Makertech3D/Proforge-3/README.md

# Proforge-3
Repository for documentation and resources related to the Proforge 3 3D Printer.
