Makertech3D/Proforge-3/3D Printed Parts STL's/DSH_Fan Shroud V2.STL

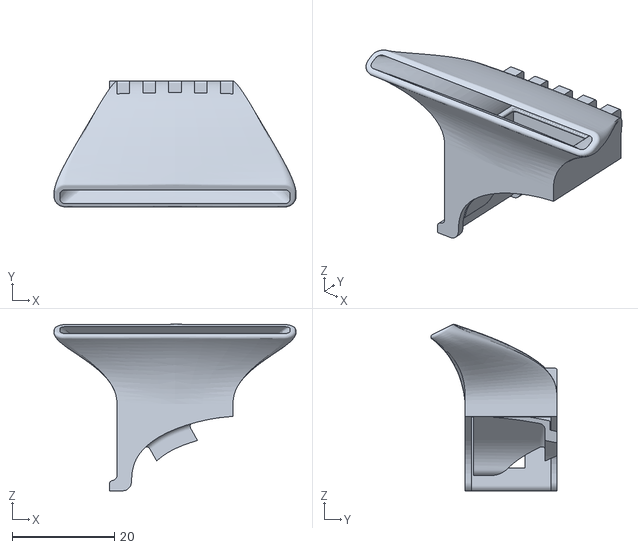
[picture p1: CAD file, 2022-07-18]
3D Printed Parts STL's/DSH_Fan Shroud V2.STL
47.3 x 24.7 x 32.6
