Makertech3D/Proforge-3/Part Drawings/P3_Pi Cam Case.STEP

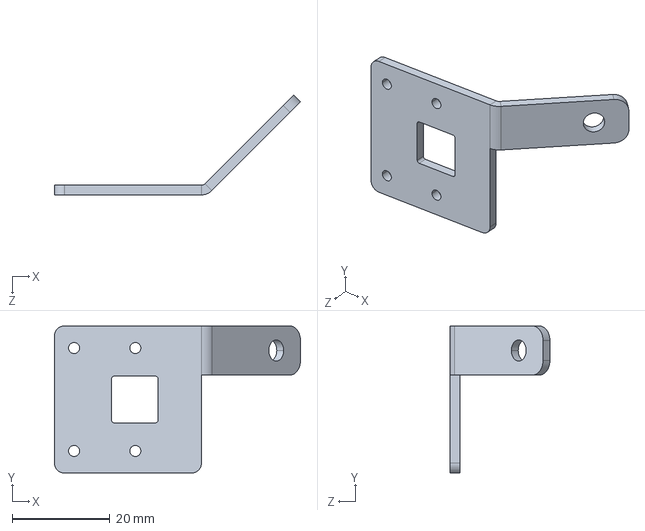
[picture p2: CAD file, 2022-07-18]
Part Drawings/P3_Pi Cam Case.STEP
50.2 x 30.0 x 20.4 mm
