Makertech3D/Proforge-3/3D Printed Parts STL's/DSH_Servo Arm V2.STL

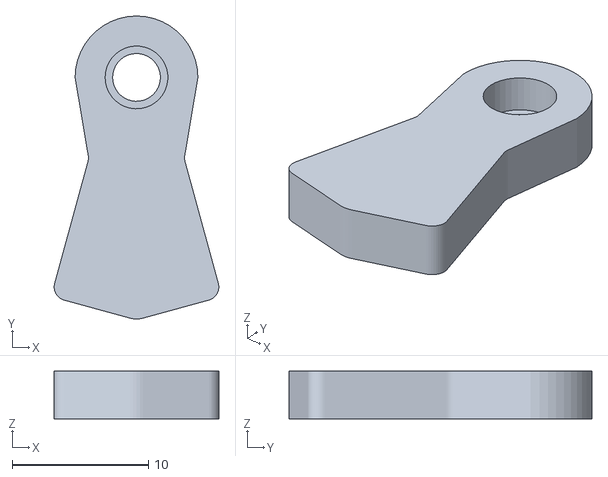
[picture p3: CAD file, 2022-07-18]
3D Printed Parts STL's/DSH_Servo Arm V2.STL
12.1 x 22.2 x 3.50
