Makertech3D/Proforge-3/Part Drawings/P3_MIC-6 Platform.STEP

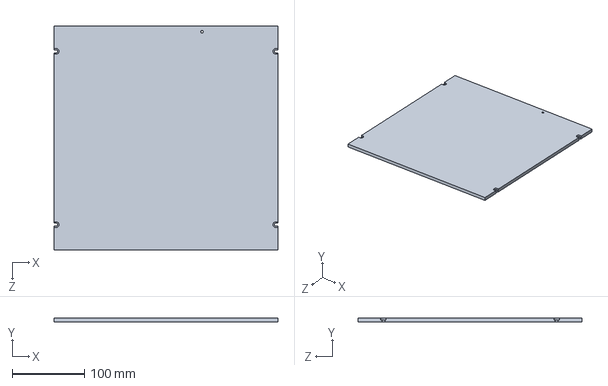
[picture p4: CAD file, 2022-07-18]
Part Drawings/P3_MIC-6 Platform.STEP
310.0 x 6.00 x 310.0 mm
