Makertech3D/Proforge-3/3D Printed Parts STL's/OctoPi_Pi Cam Case.STL

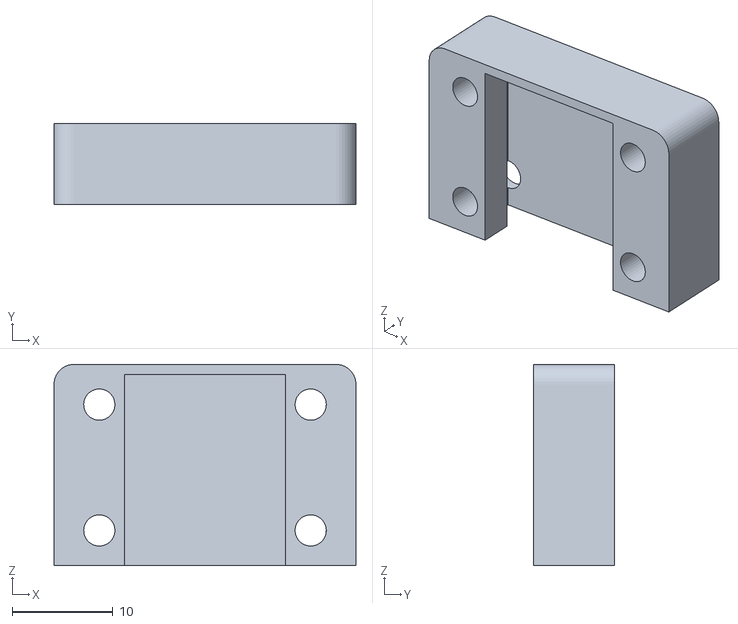
[picture p5: CAD file, 2022-03-18]
3D Printed Parts STL's/OctoPi_Pi Cam Case.STL
30.0 x 8.00 x 20.0
