Makertech3D/Proforge-3/Part Drawings/P3_Top Panel.STEP

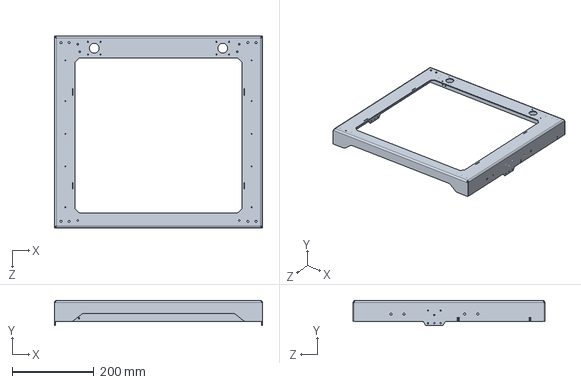
[picture p6: CAD file, 2022-07-18]
Part Drawings/P3_Top Panel.STEP
510.0 x 62.0 x 470.0 mm
