Makertech3D/Proforge-3/3D Printed Parts STL's/Enclosure_Filter Case.STL

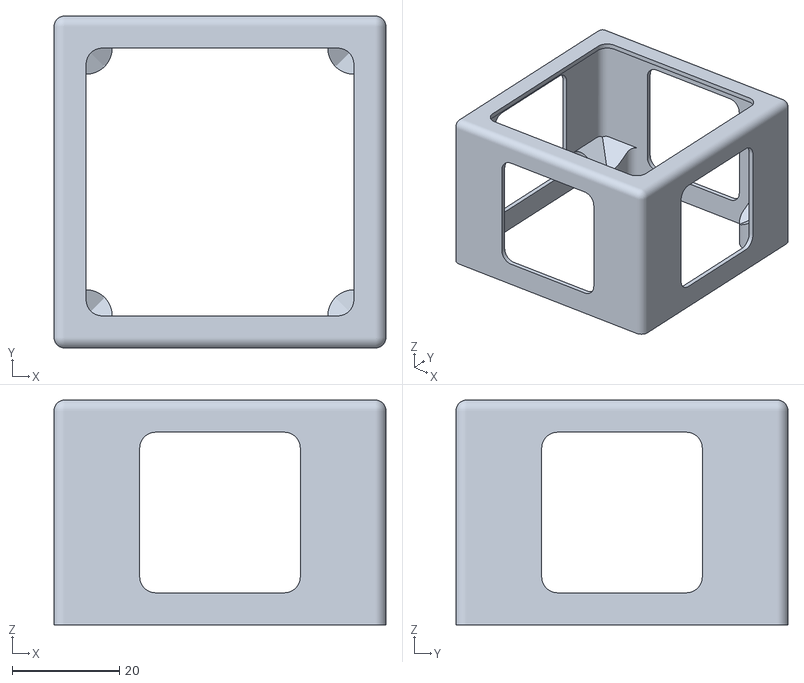
[picture p7: CAD file, 2022-03-18]
3D Printed Parts STL's/Enclosure_Filter Case.STL
62.0 x 62.0 x 42.0
