Makertech3D/Proforge-3/Part Drawings/P3_Filament Sensor Mount.STEP

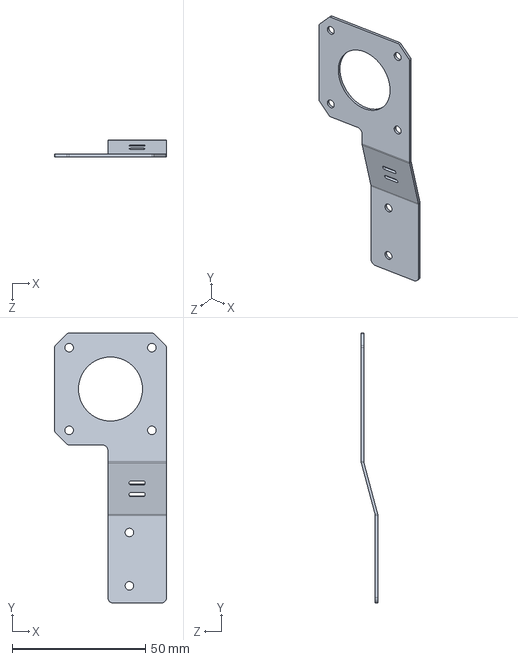
[picture p8: CAD file, 2022-07-18]
Part Drawings/P3_Filament Sensor Mount.STEP
42.0 x 101.2 x 6.30 mm
