Makertech3D/Proforge-3/3D Printed Parts STL's/DD_Fan Case.STL

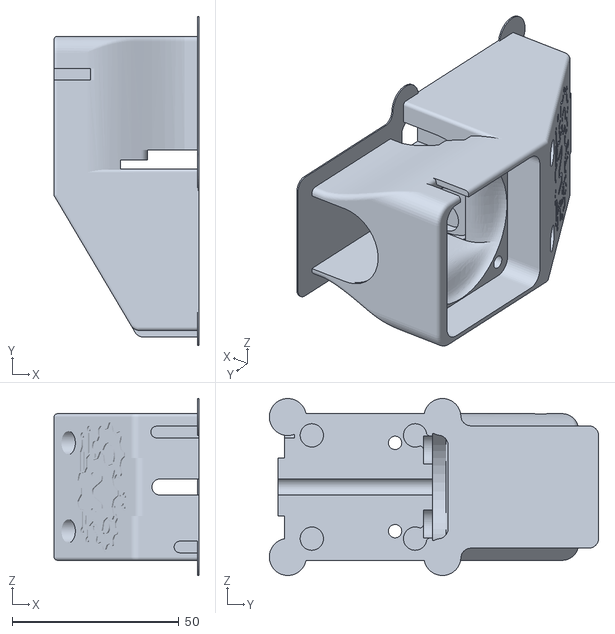
[picture p9: CAD file, 2022-03-18]
3D Printed Parts STL's/DD_Fan Case.STL
43.5 x 98.9 x 53.1
