Makertech3D/Proforge-3/Part Drawings/P3_Belt Clamp.STEP

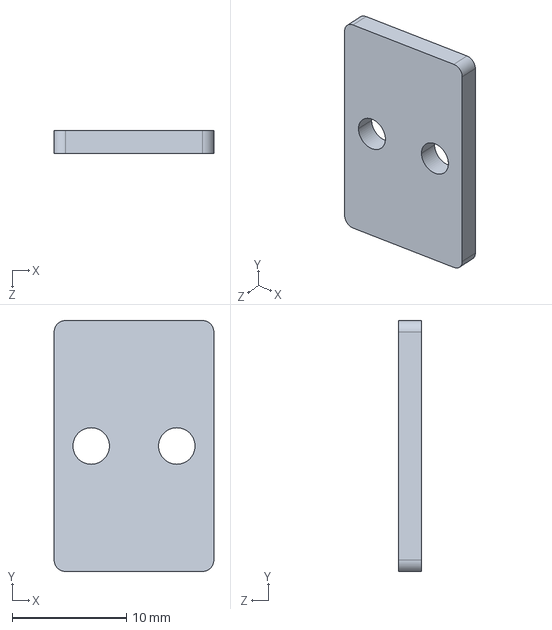
[picture p10: CAD file, 2022-07-18]
Part Drawings/P3_Belt Clamp.STEP
14.0 x 22.0 x 2.00 mm
