Makertech3D/Proforge-3/3D Printed Parts STL's/DSH_Probe Mount.STL

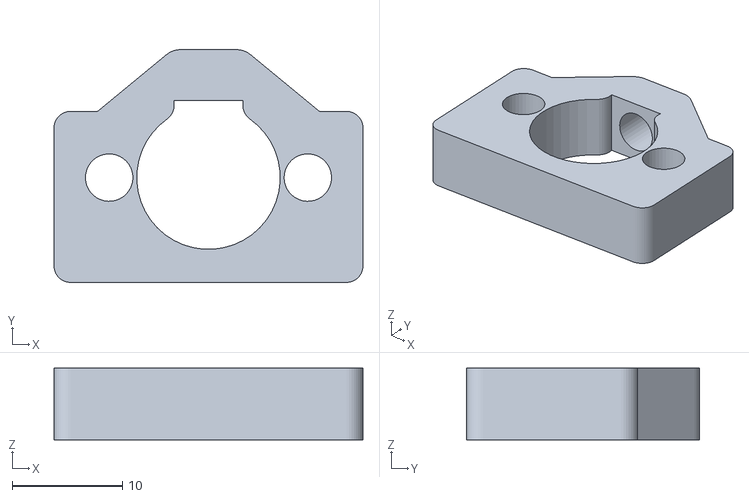
[picture p11: CAD file, 2022-03-18]
3D Printed Parts STL's/DSH_Probe Mount.STL
28.0 x 21.1 x 6.50
