Makertech3D/Proforge-3/Part Drawings/P3_Enclosure Roof.STEP

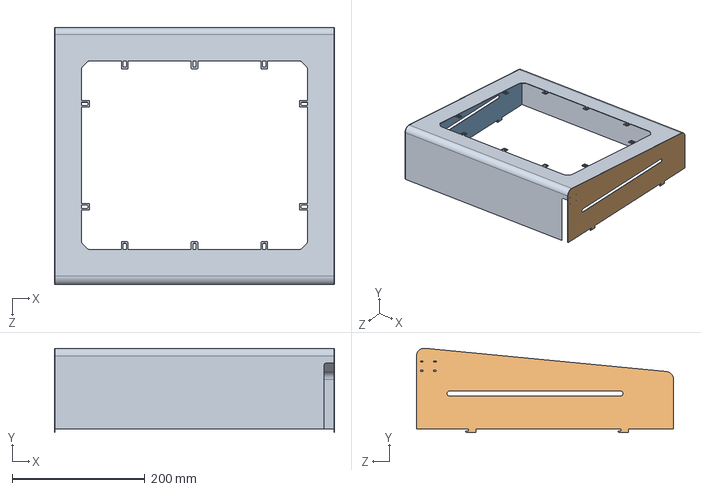
[picture p12: CAD file, 2022-07-18]
Part Drawings/P3_Enclosure Roof.STEP
422.3 x 127.4 x 388.0 mm
