Makertech3D/Proforge-3/3D Printed Parts STL's/DD_Fan Shroud (mirror for other side).STL

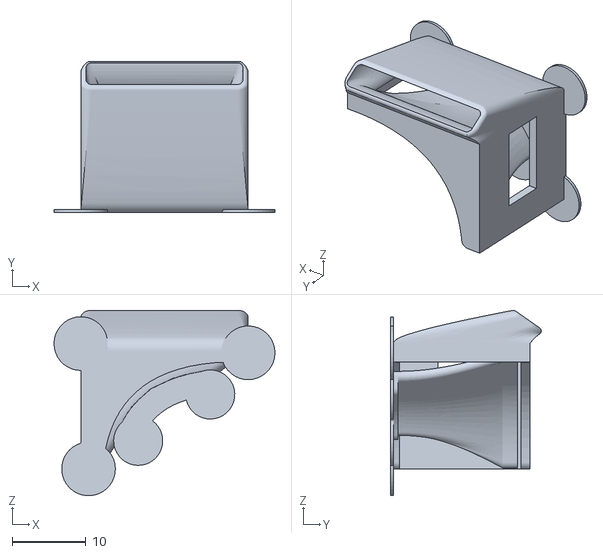
[picture p13: CAD file, 2022-03-18]
3D Printed Parts STL's/DD_Fan Shroud (mirror for other side).STL
30.0 x 20.4 x 25.2
