Makertech3D/Proforge-3/Part Drawings/P3_LCD Case_BTT_v3.STEP

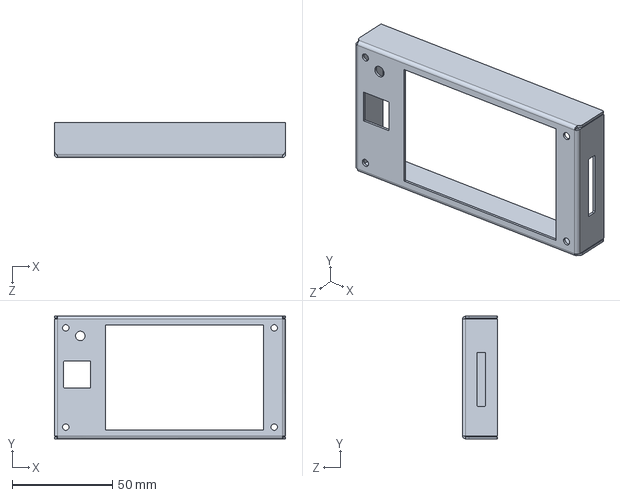
[picture p14: CAD file, 2022-07-18]
Part Drawings/P3_LCD Case_BTT_v3.STEP
115.0 x 61.0 x 17.5 mm
