Makertech3D/Proforge-3/3D Printed Parts STL's/P3_Foot.STL

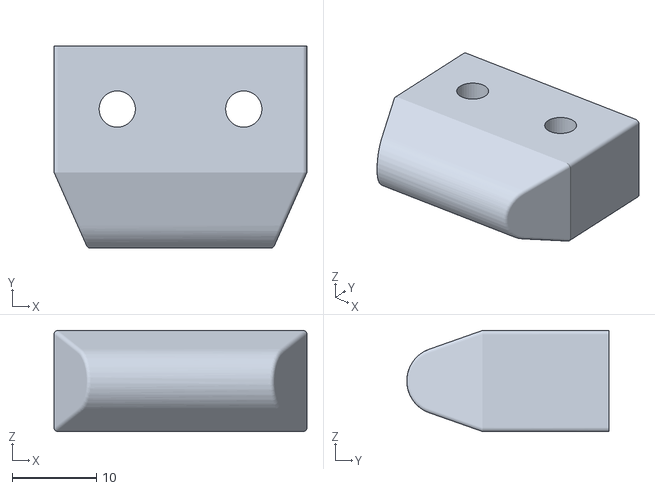
[picture p15: CAD file, 2022-03-18]
3D Printed Parts STL's/P3_Foot.STL
30.0 x 24.0 x 12.0
