Makertech3D/Proforge-3/Part Drawings/DSH2_Backplate.STEP

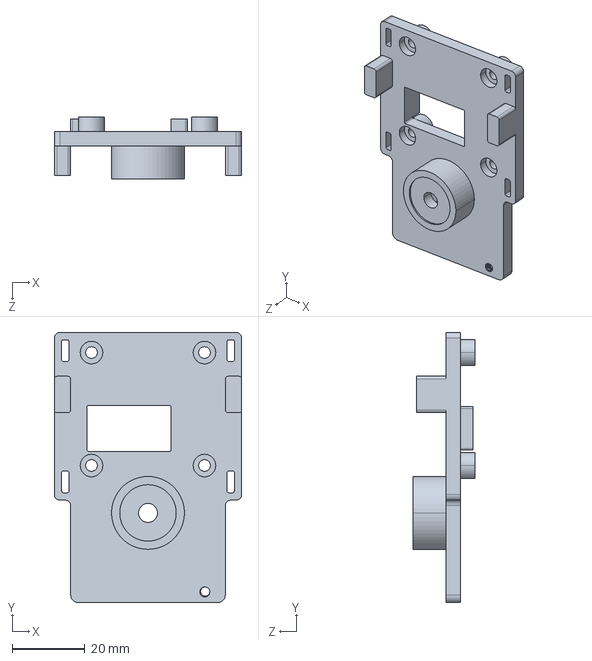
[picture p16: CAD file, 2022-07-18]
Part Drawings/DSH2_Backplate.STEP
51.4 x 74.1 x 17.0 mm
