Makertech3D/Proforge-3/3D Printed Parts STL's/DSH_Fan Mount.STL

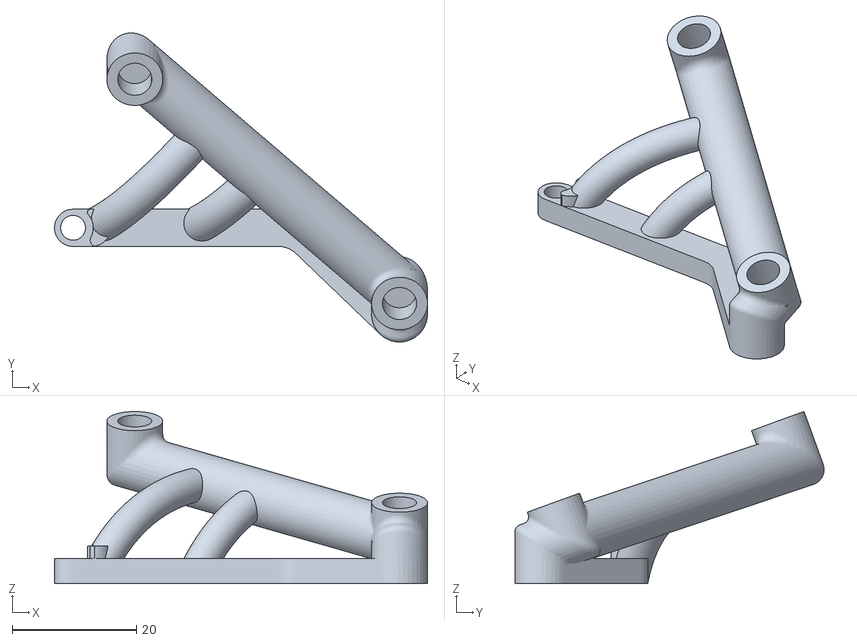
[picture p17: CAD file, 2022-03-18]
3D Printed Parts STL's/DSH_Fan Mount.STL
60.0 x 49.7 x 27.7
