Makertech3D/Proforge-3/Part Drawings/P3_Tool Carriage.STEP

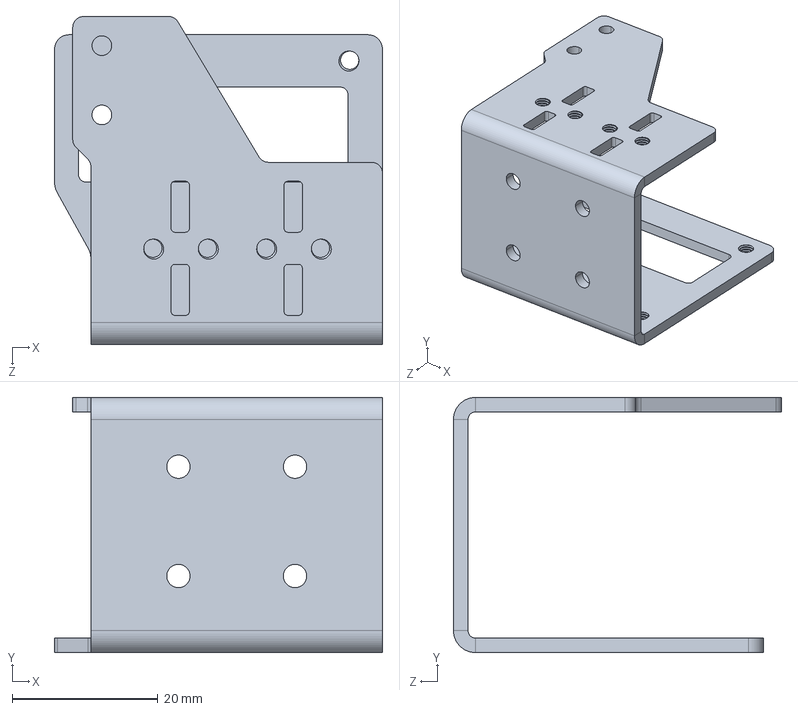
[picture p18: CAD file, 2022-07-18]
Part Drawings/P3_Tool Carriage.STEP
45.0 x 35.0 x 45.0 mm
