Makertech3D/Proforge-3/3D Printed Parts STL's/OctoPi_KIS3R33S Bracket.STL

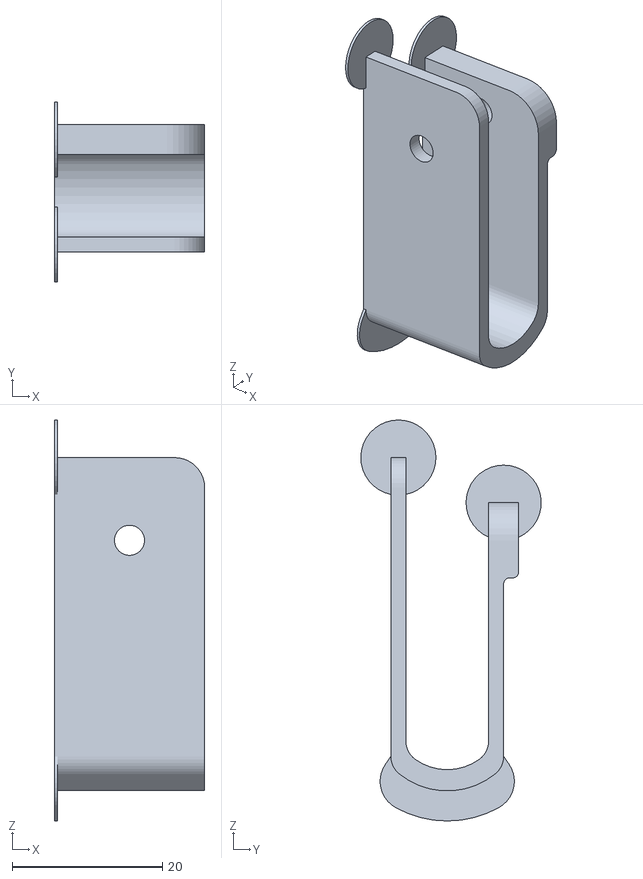
[picture p19: CAD file, 2022-03-18]
3D Printed Parts STL's/OctoPi_KIS3R33S Bracket.STL
20.0 x 24.0 x 53.3
