Makertech3D/Proforge-3/Part Drawings/Tool Carriage.STEP

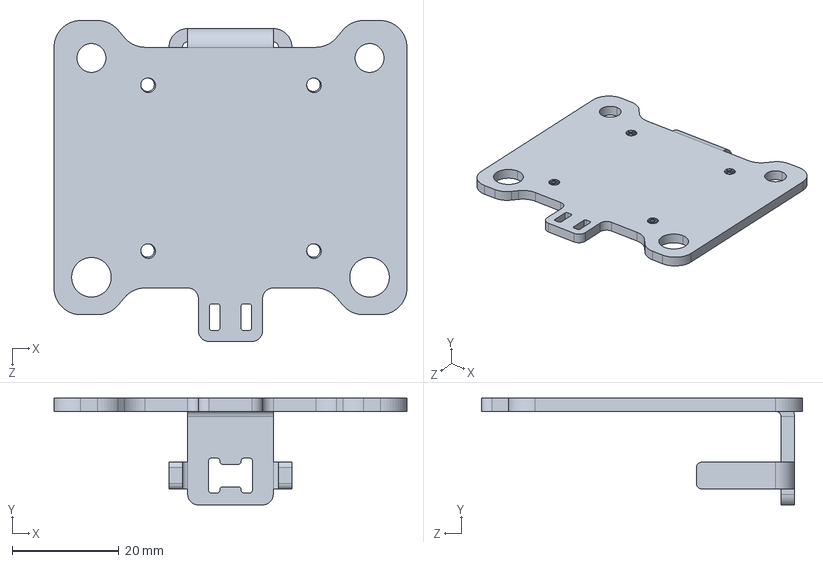
[picture p20: CAD file, 2022-07-18]
Part Drawings/Tool Carriage.STEP
66.0 x 20.0 x 60.0 mm
