Makertech3D/Proforge-3/3D Printed Parts STL's/DD_Filament Sensor Mount.STL

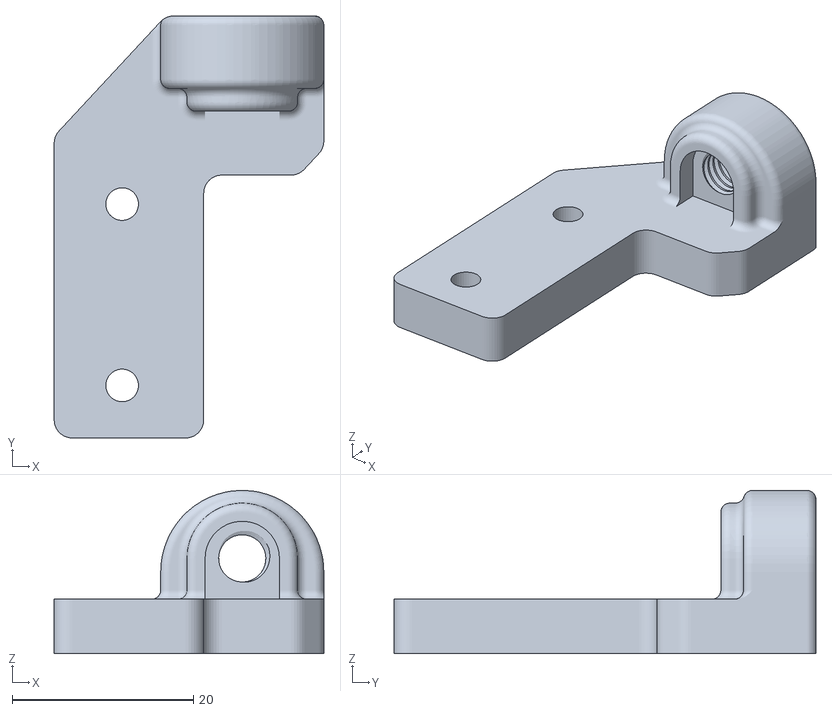
[picture p21: CAD file, 2022-03-18]
3D Printed Parts STL's/DD_Filament Sensor Mount.STL
29.8 x 46.5 x 18.0
