Makertech3D/Proforge-3/Part Drawings/DSH2_Probe and Fan Mount.STEP

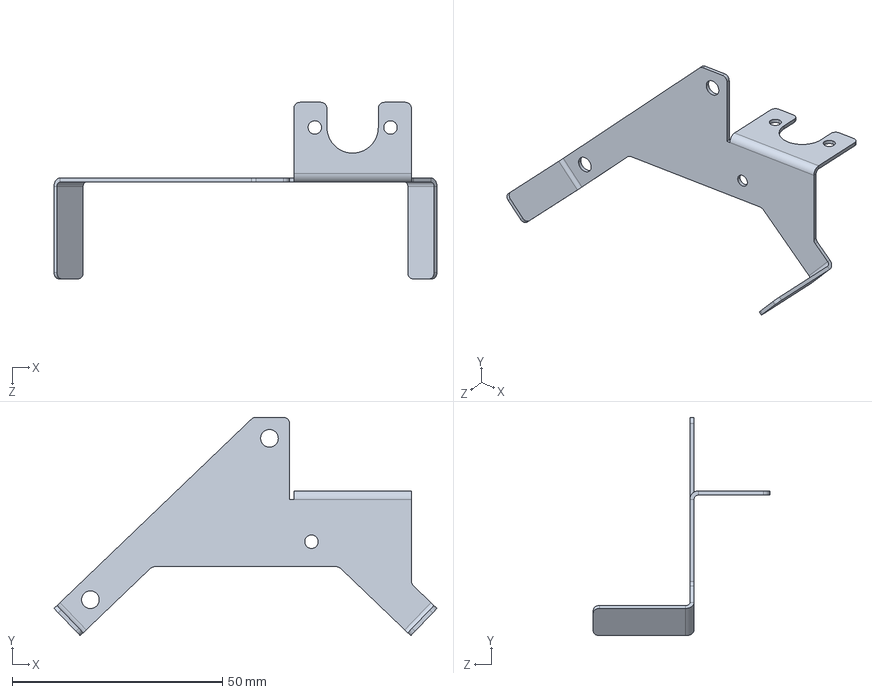
[picture p22: CAD file, 2022-07-18]
Part Drawings/DSH2_Probe and Fan Mount.STEP
91.1 x 52.0 x 42.0 mm
