Makertech3D/Proforge-3/Part Drawings/P3_Base.STEP

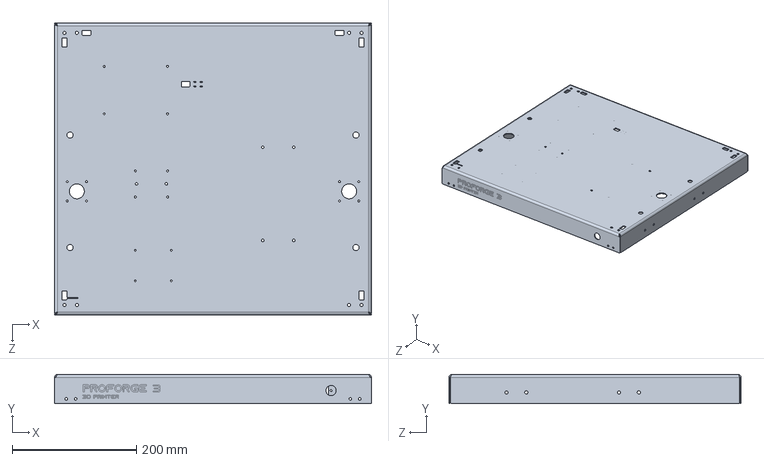
[picture p23: CAD file, 2022-07-18]
Part Drawings/P3_Base.STEP
510.0 x 47.0 x 470.1 mm
