Makertech3D/Proforge-3/Part Drawings/P3_Enclosure Lock.STEP

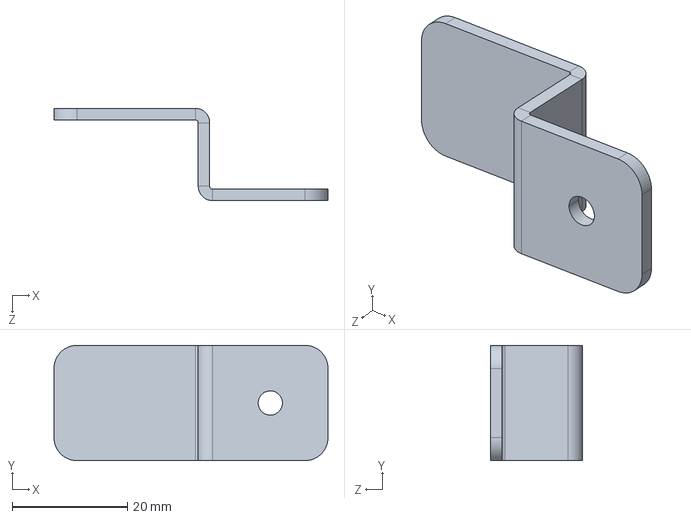
[picture p24: CAD file, 2022-07-18]
Part Drawings/P3_Enclosure Lock.STEP
47.5 x 20.0 x 16.0 mm
