Makertech3D/Proforge-3/Part Drawings/DD Mount.STEP

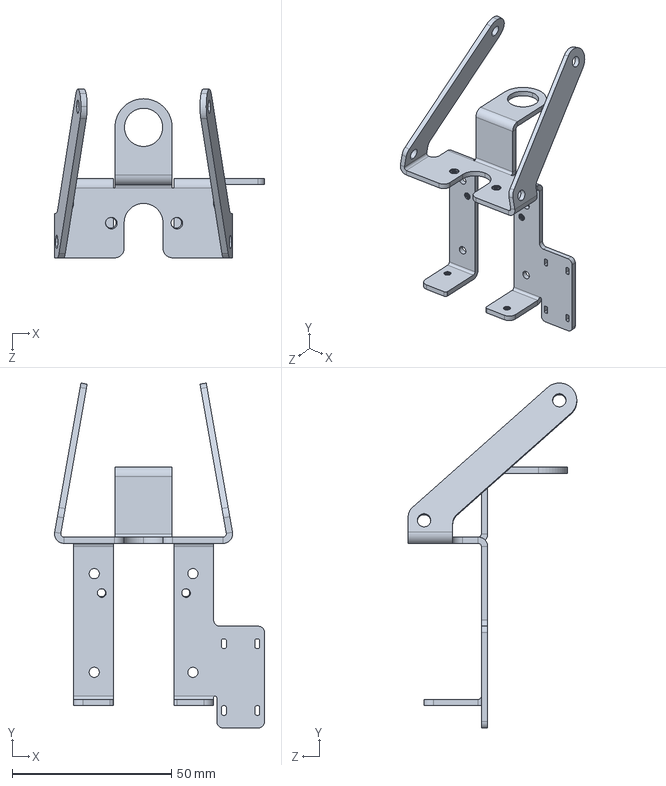
[picture p25: CAD file, 2022-07-18]
Part Drawings/DD Mount.STEP
66.0 x 108.4 x 53.0 mm
