Makertech3D/Proforge-3/Part Drawings/P3_Gantry.STEP

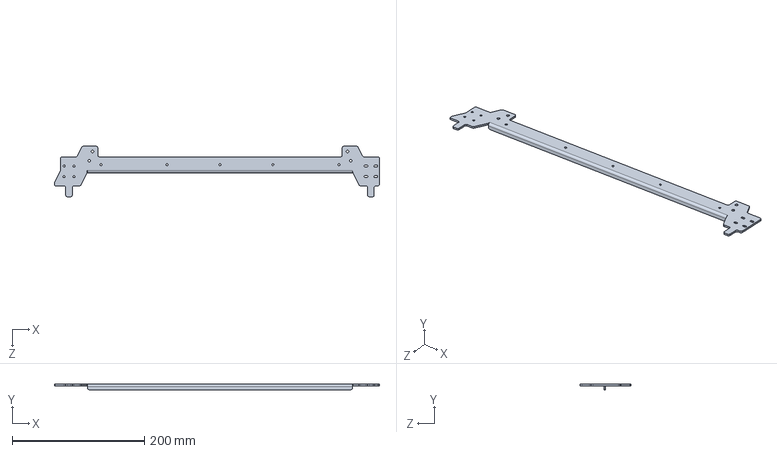
[picture p26: CAD file, 2022-07-18]
Part Drawings/P3_Gantry.STEP
492.0 x 8.50 x 76.5 mm
