Makertech3D/Proforge-3/Part Drawings/P3_LCD Case Back_BTT_v3.STEP

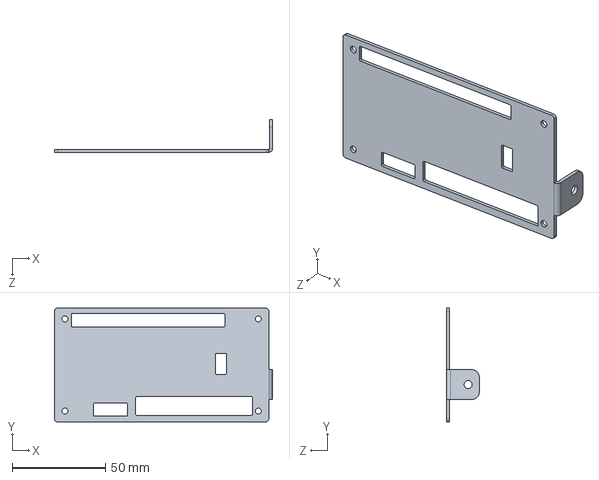
[picture p27: CAD file, 2022-07-18]
Part Drawings/P3_LCD Case Back_BTT_v3.STEP
117.0 x 61.0 x 17.5 mm
