Makertech3D/Proforge-3/Part Drawings/P3_Bed Cable Relief.STEP

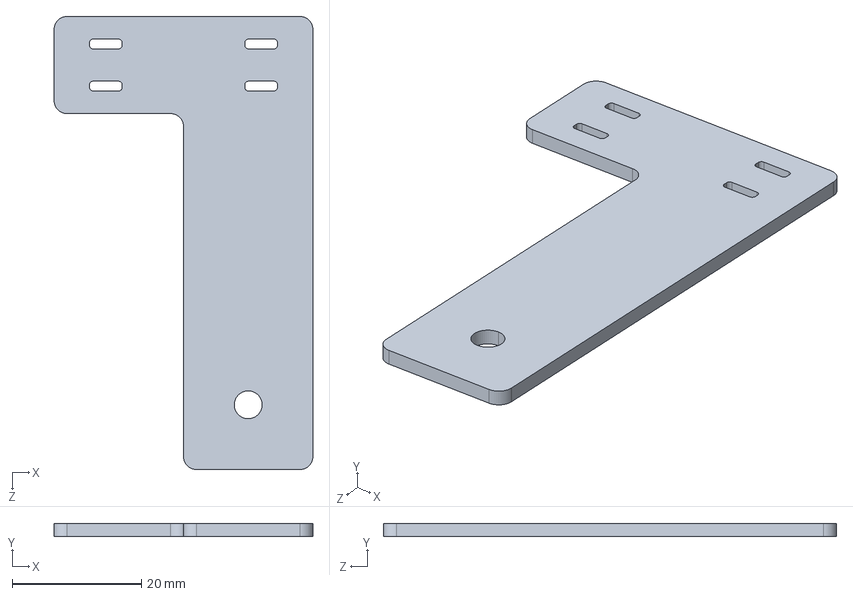
[picture p28: CAD file, 2022-07-18]
Part Drawings/P3_Bed Cable Relief.STEP
40.0 x 2.00 x 70.0 mm
