Makertech3D/Proforge-3/(threads)

Thread 1 (2022-03-02):

Initial bugs after release

freddy2312, 2022-03-02:
These were the following mistakes I found:
- X and Y Axis are inverted
- Temperature is very sure false (180°C smells very burned
- PID is not tuned correct
- when loading and unloading, the Bed goes up like 4cm before the filament comes out!!!
- when started the error „failed to enable Bed Leveling“ pops up on the screen

Makertech3D, 2022-03-06:
Stepper directions have been further investigated. The cables on our set-up were inverted in comparison to the ones in inventory. Firmware has been updated. If issues persist, we recommend either compiling from source and inverting the stepper directions or just post a message here, and we'll upload compiled inverted stepper firmwares.

freddy2312, 2022-03-07:
Thanks for updating and for sharing the source! Do you already know when you will upload the cad files and the 3D print files? Thanks a lot :)

Thread 2 (2022-05-07):

missing name in thermistornames.h

PowerChaos, 2022-05-07:
hi,
this is just a bug report and a quick fix

as i was compiling i keep getting the error that it can not complete the compile
seems that thermistor ID 560 is not defined in Thermistornames.h

after adding it manual to it , then it compiles
This is for the source code

can you update it in the zip file please

`#elif THERMISTOR_ID == 560
   #define THERMISTOR_NAME "Makertech High Temp. Thermistor"
`

Thank you
Greetings from PowerChhaos

Thread 3 (2024-03-11):

Part Drawings enclosure panels

octocom, 2024-03-11:
Hi,

Can you add the enclosure panels part drawings please, seem to be missing.

Best Regards

Luke
