Makertech3D/Proforge-3/Part Drawings/DD Mount.pdf

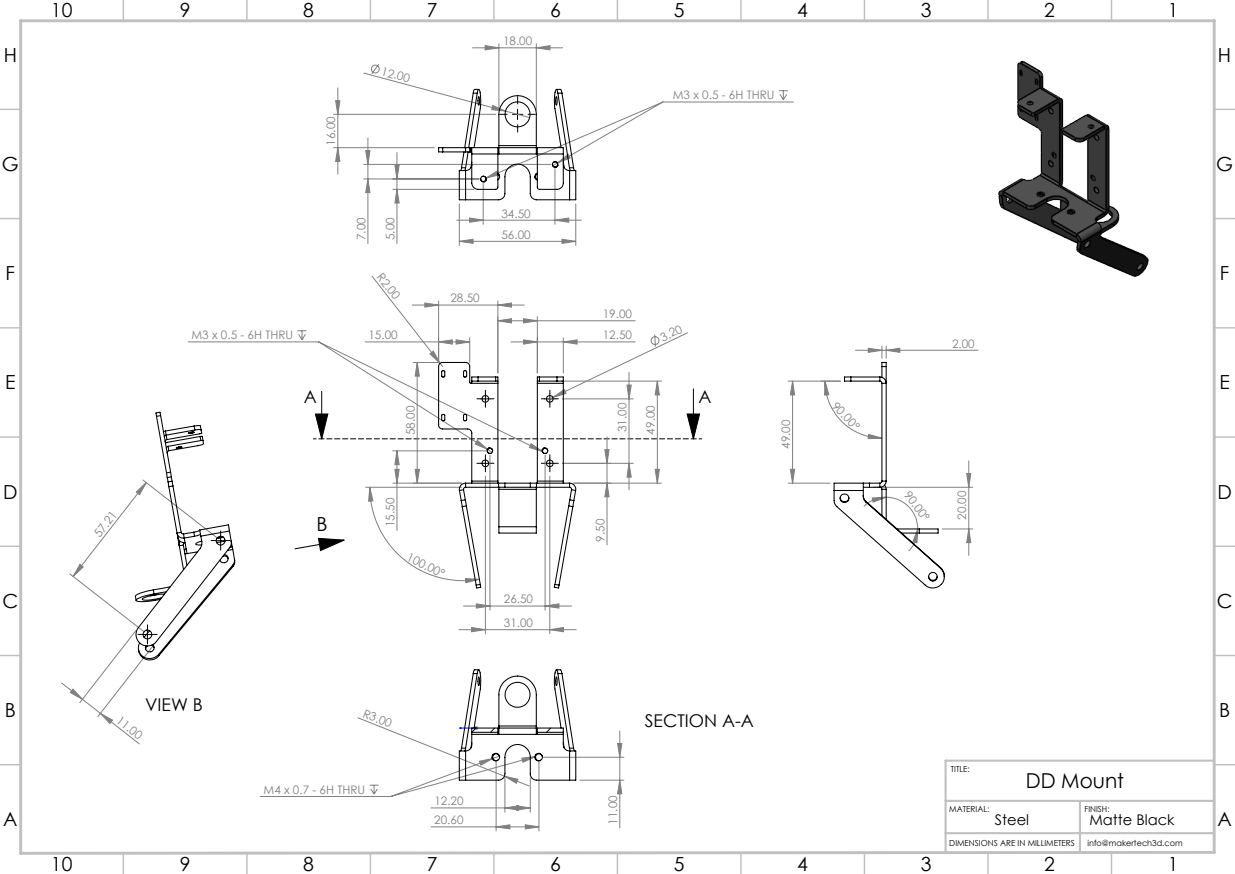
[picture p29: page 1]
M3 x 0.5 - 6H THRU; M4 x 0.7 - 6H THRU; SECTION A-A 11.00; VIEW B; DD Mount

MATERIAL: | FINISH: Matte Black

DIMENSIONS ARE IN MILLIMETERS | info@makertech3d.com
