Makertech3D/Proforge-3/Part Drawings/DSH2_Backplate.pdf

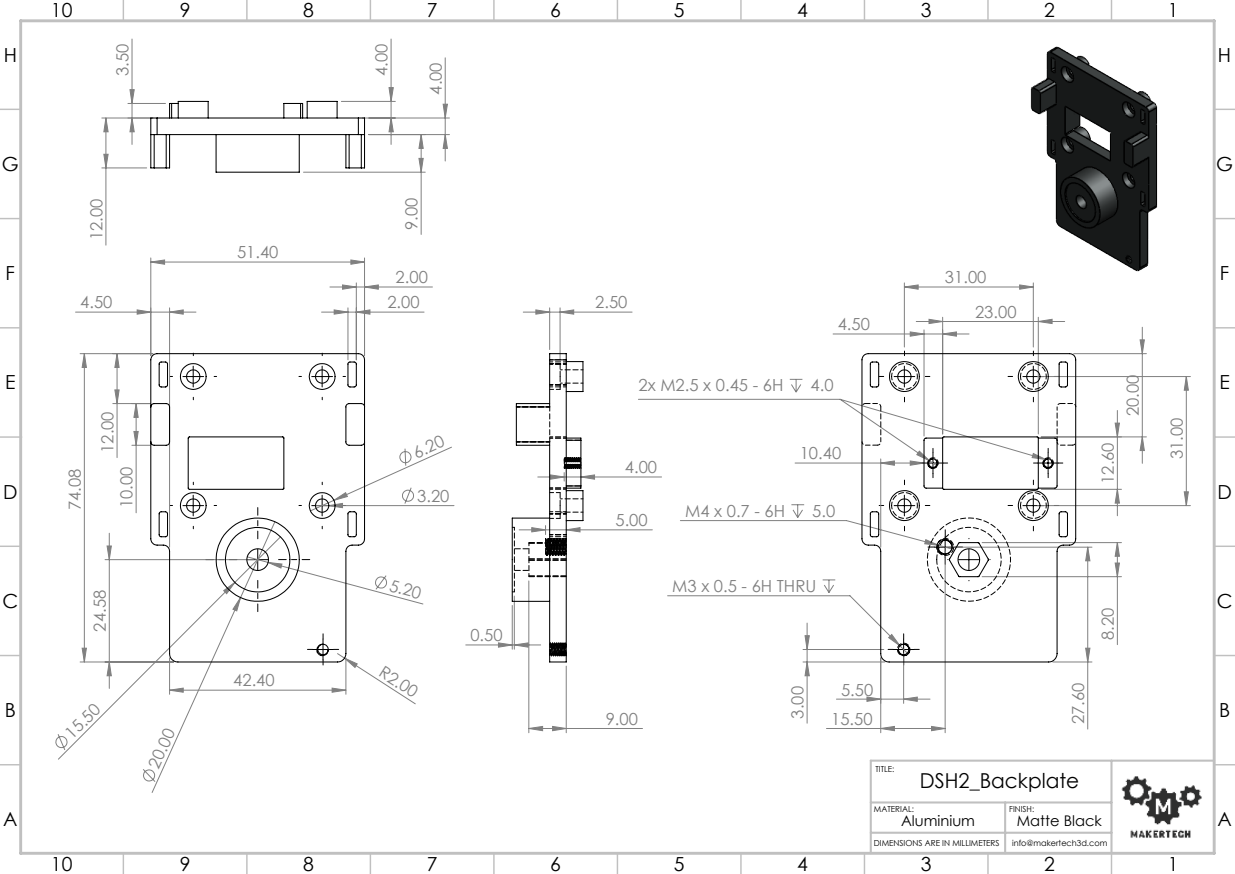
[picture p30: page 1]
M3 x 0.5 - 6H THRU; Matte Black

TITLE: DSH2_Backplate

MATERIAL: Aluminium | FINISH:

DIMENSIONS ARE IN MILLIMETERS | info@makertech3d.com
