Makertech3D/Proforge-3/Part Drawings/DSH2_Heatsink.pdf

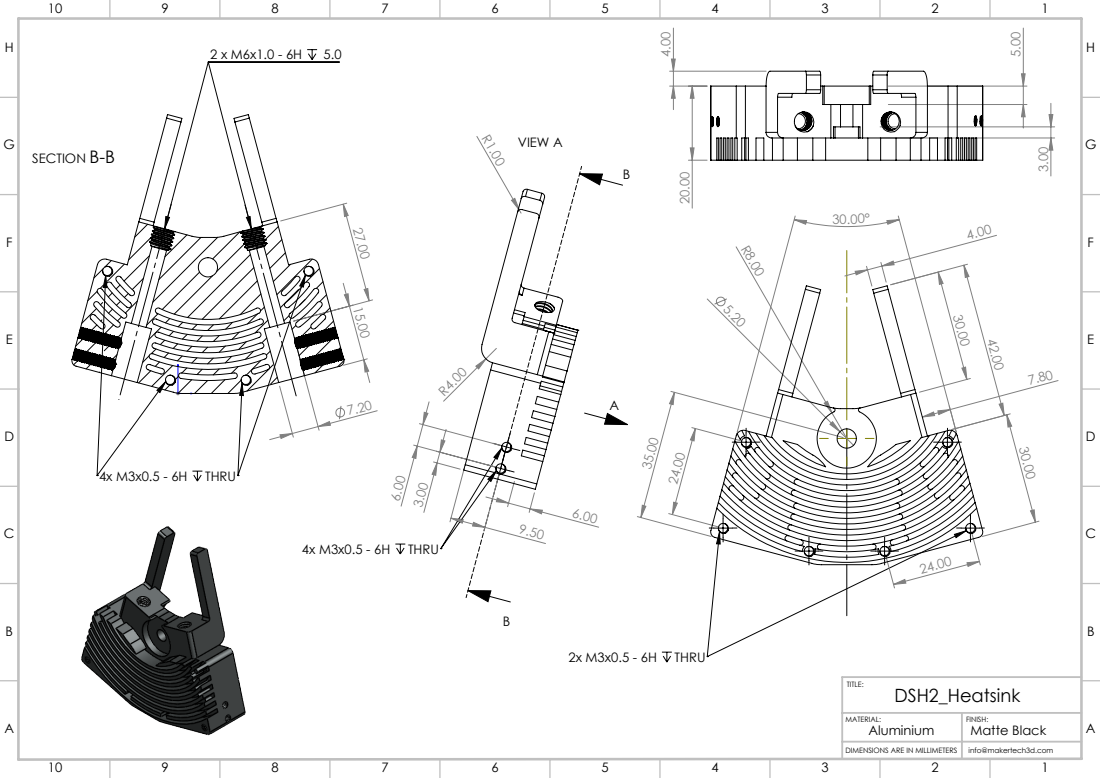
[picture p31: page 1]
2x M3x0.5 - 6H THRU 20.00 4.00; VIEW A; 4x M3x0.5 - 6H THRU; SECTION B-B

MATERIAL: | FINISH: Matte Black

DIMENSIONS ARE IN MILLIMETERS | info@makertech3d.com
