Makertech3D/Proforge-3/Part Drawings/DSH2_Probe and Fan Mount.pdf

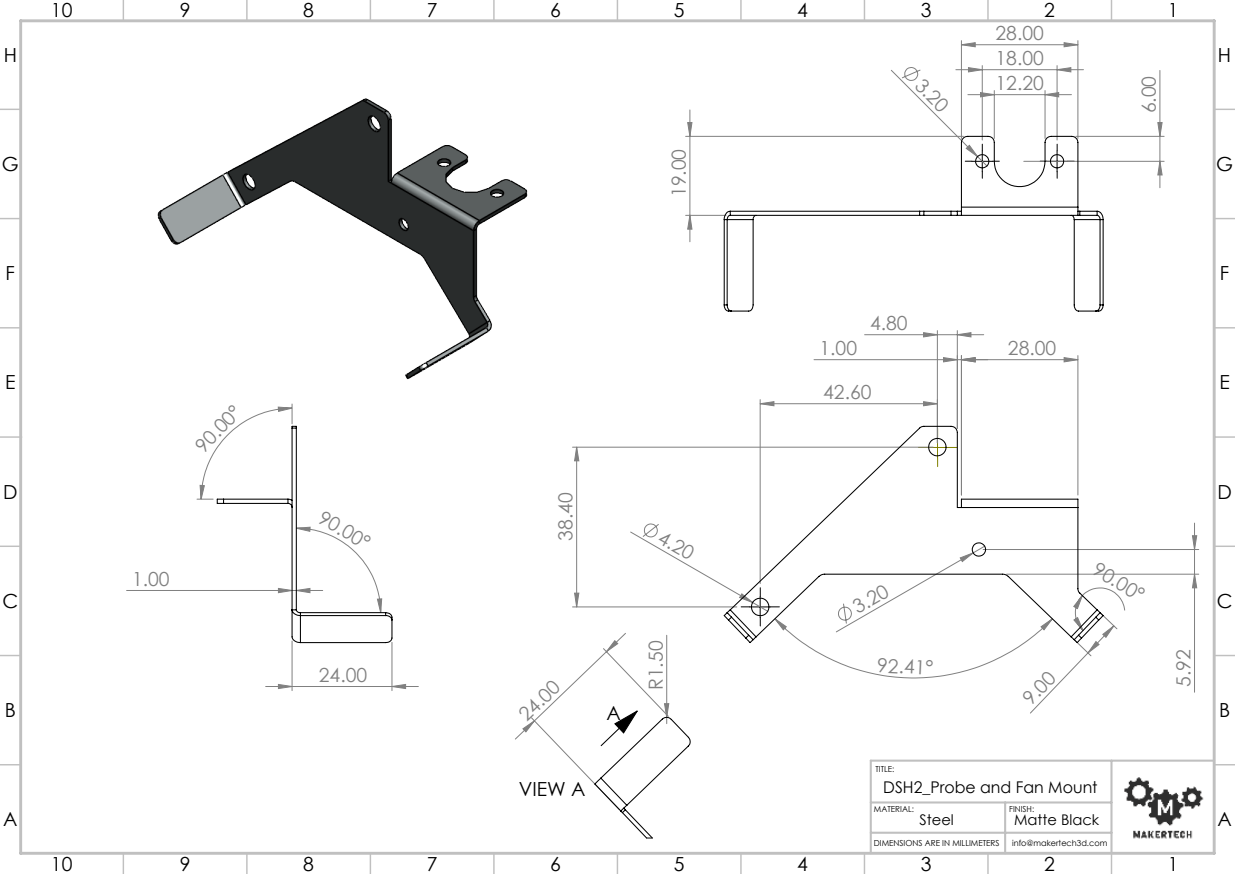
[picture p32: page 1]
VIEW A

TITLE: DSH2_Probe and Fan Mount

MATERIAL: | FINISH: Matte Black

DIMENSIONS ARE IN MILLIMETERS | info@makertech3d.com
