Makertech3D/Proforge-3/Part Drawings/P3_Base.pdf

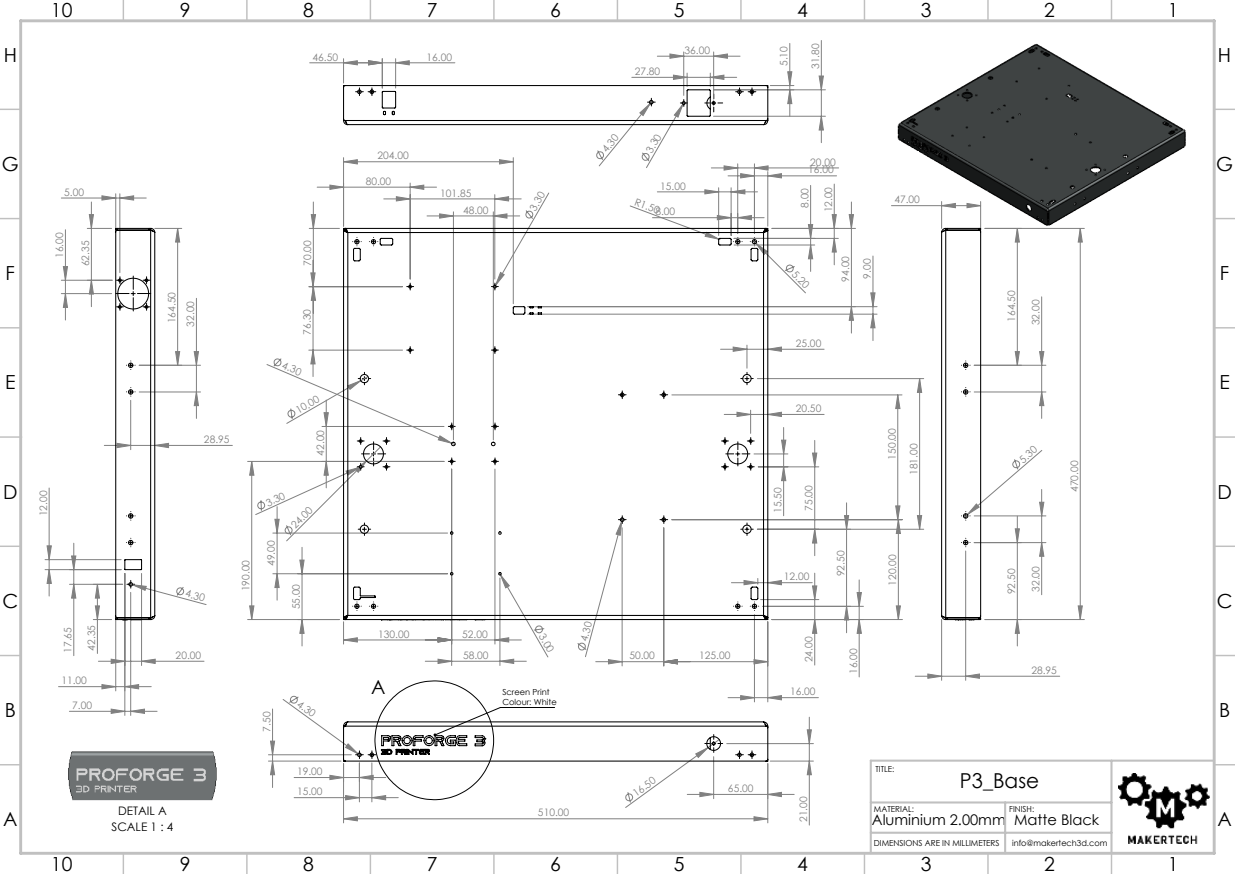
[picture p33: page 1]
Screen Print; Colour: White; DETAIL A SCALE 1 : 4; Aluminium 2.00mm

TITLE: P3_Base

MATERIAL: | FINISH: Matte Black

DIMENSIONS ARE IN MILLIMETERS | info@makertech3d.com

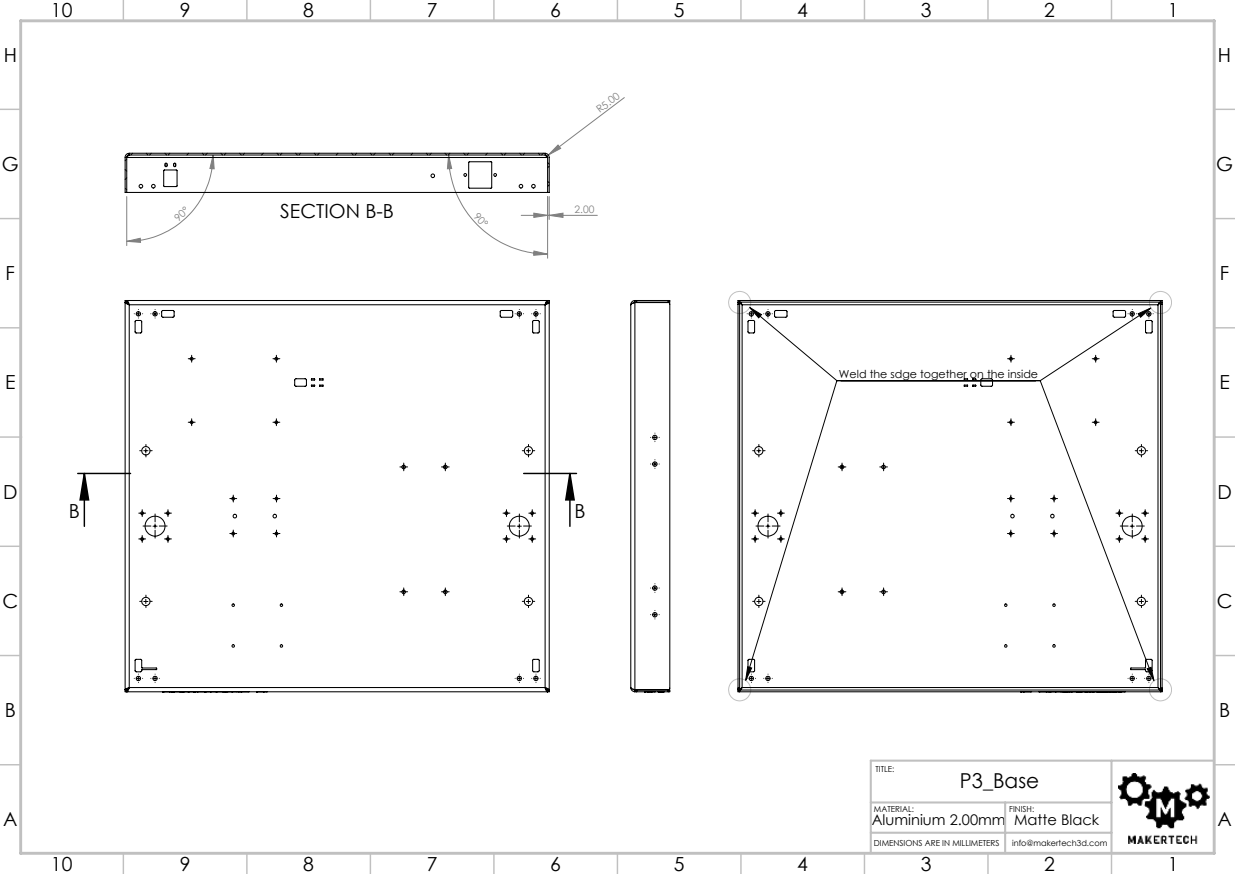
[picture p34: page 2]
SECTION B-B; Aluminium 2.00mm

Weld the sdge together on the inside

TITLE: P3_Base

MATERIAL: | FINISH: Matte Black

DIMENSIONS ARE IN MILLIMETERS | info@makertech3d.com
