Makertech3D/Proforge-3/Part Drawings/P3_Bed Cable Relief.pdf

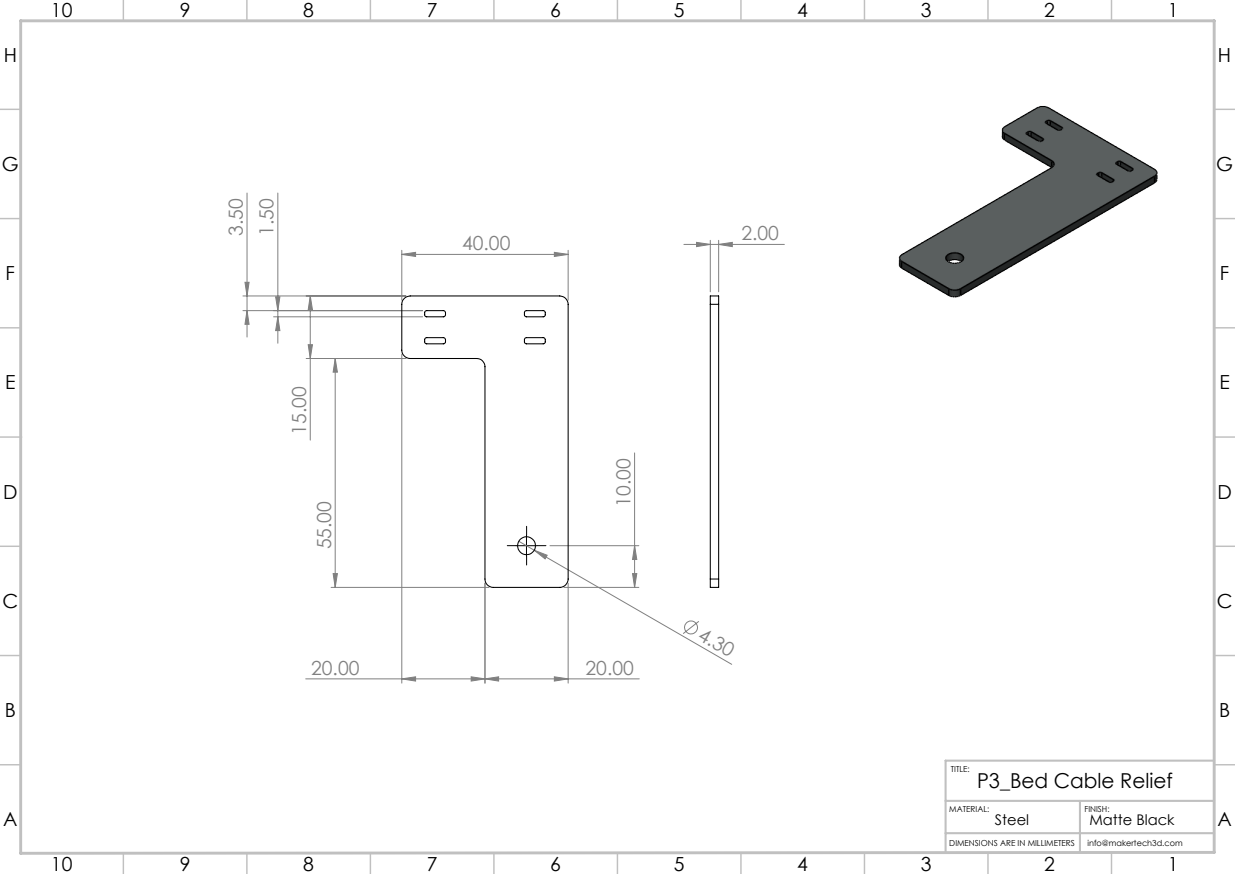
[picture p35: page 1]
P3_Bed Cable Relief

MATERIAL: | FINISH: Matte Black

DIMENSIONS ARE IN MILLIMETERS | info@makertech3d.com
