Makertech3D/Proforge-3/Part Drawings/P3_Belt Clamp.pdf

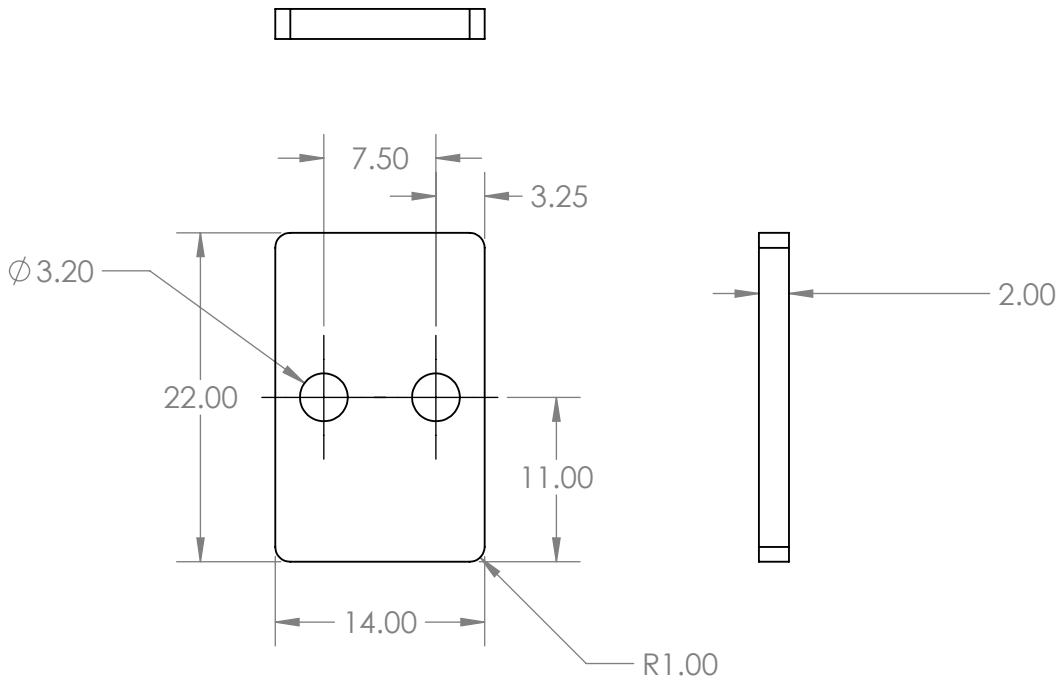
[picture p36: page 1]

TITLE: P3_Belt Clamp

MATERIAL: | FINISH: Matte Black

DIMENSIONS ARE IN MILLIMETERS | info@makertech3d.com
