Makertech3D/Proforge-3/Part Drawings/P3_Enclosure Lock.PDF

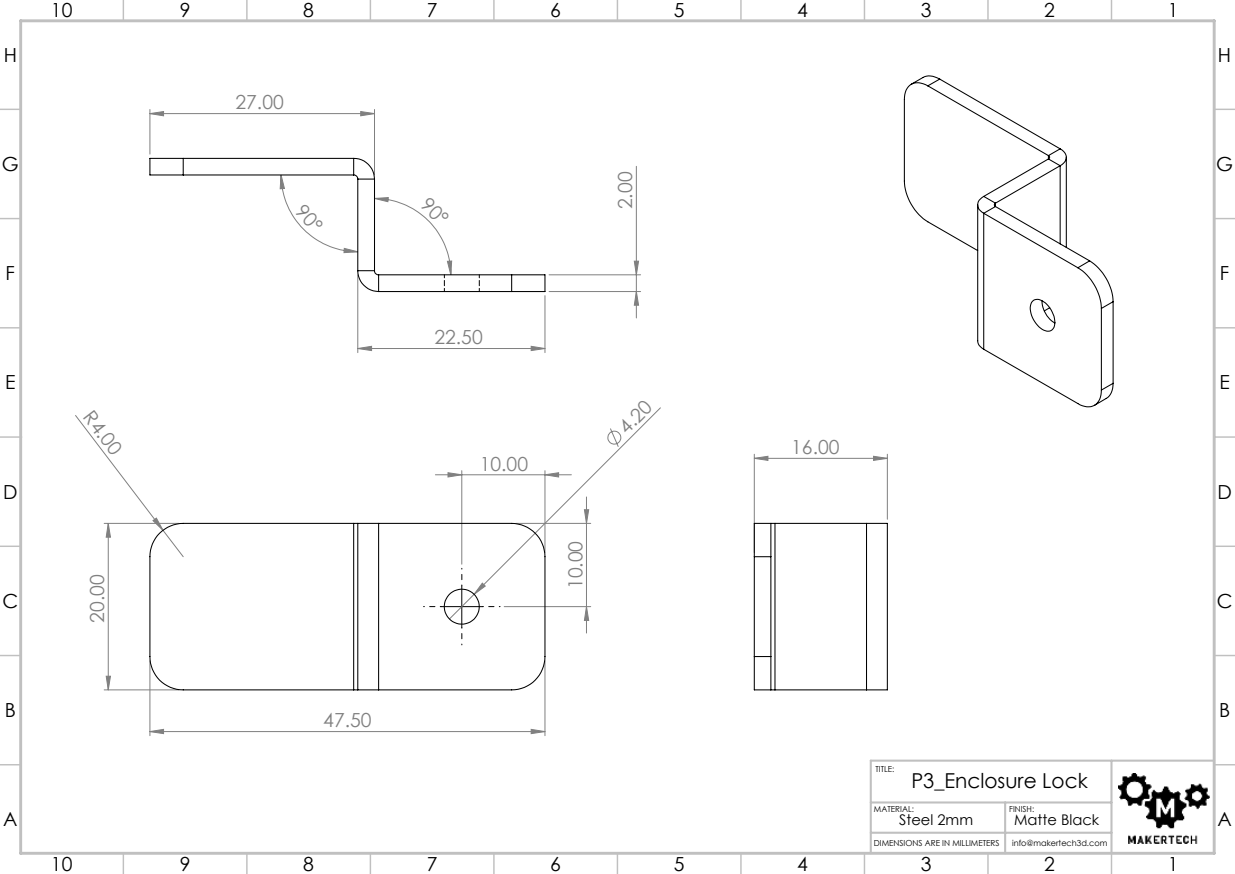
[picture p37: page 1]
Steel 2mm

90° DIMENSIONS ARE IN MILLIMETERS

TITLE: P3_Enclosure Lock

MATERIAL: | FINISH: Matte Black

info@makertech3d.com
