Makertech3D/Proforge-3/Part Drawings/P3_Enclosure Roof.pdf

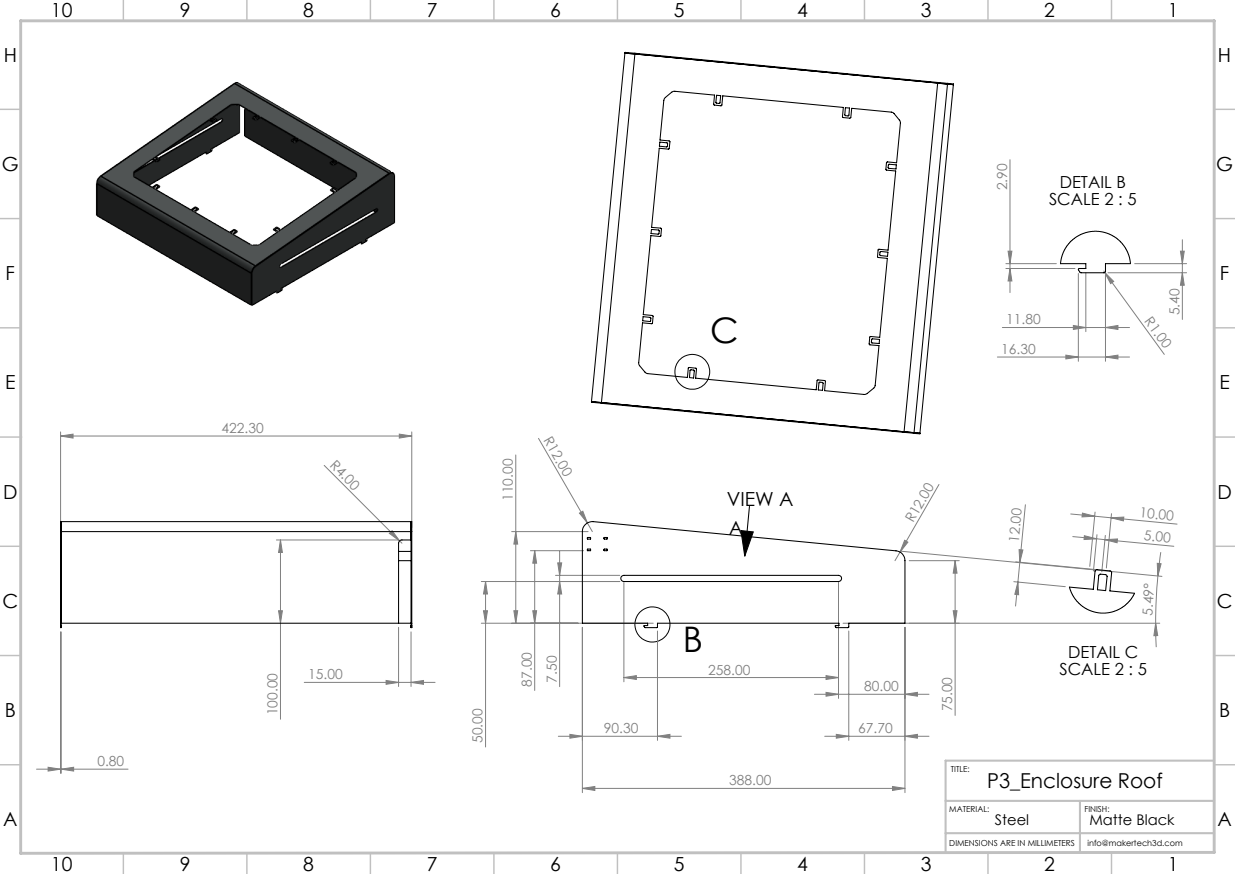
[picture p38: page 1]
VIEW A; DETAIL B SCALE 2 : 5; DETAIL C SCALE 2 : 5; P3_Enclosure Roof

MATERIAL: | FINISH: Matte Black

DIMENSIONS ARE IN MILLIMETERS | info@makertech3d.com
