Makertech3D/Proforge-3/Part Drawings/P3_Filament Sensor Mount.pdf

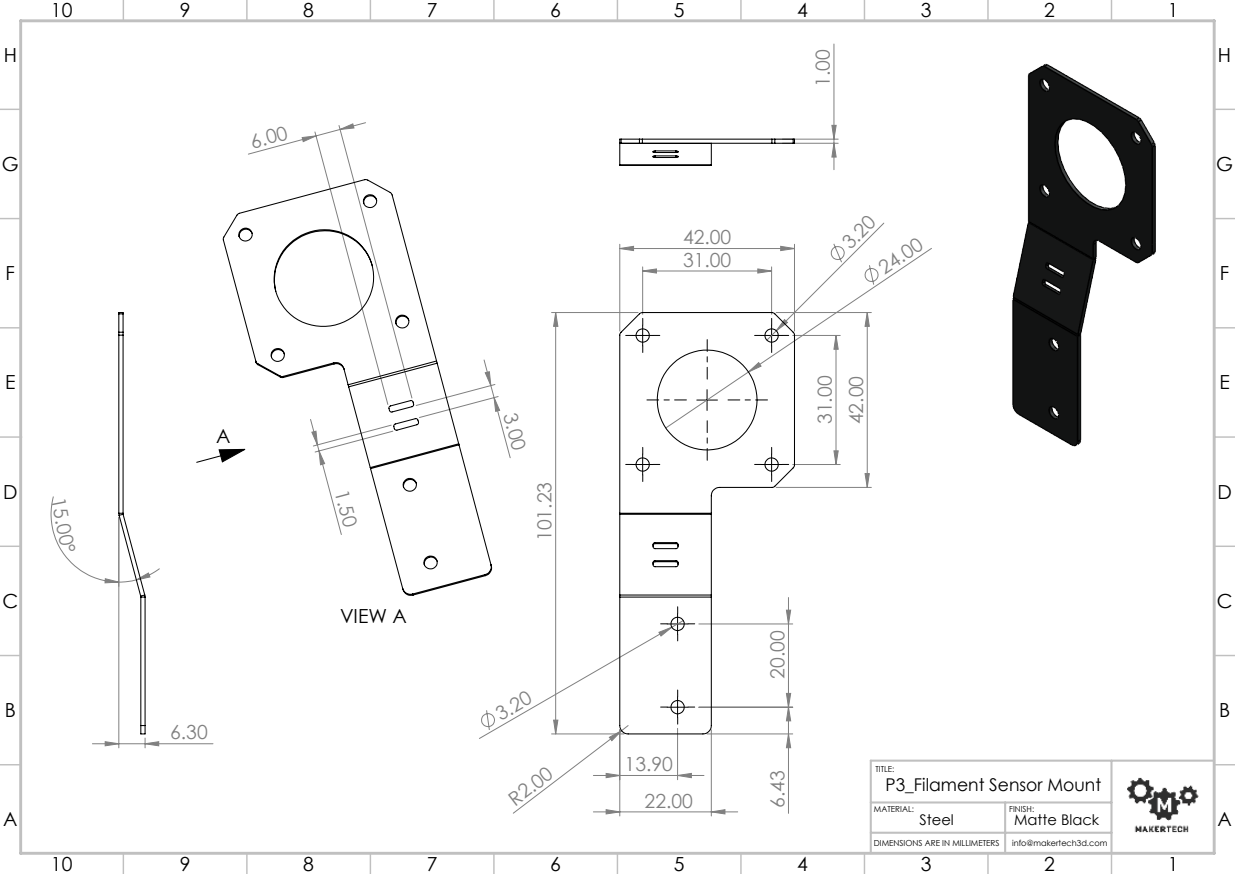
[picture p39: page 1]
VIEW A

TITLE: P3_Filament Sensor Mount

MATERIAL: | FINISH: Matte Black

DIMENSIONS ARE IN MILLIMETERS | info@makertech3d.com
