Makertech3D/Proforge-3/Part Drawings/P3_Gantry.pdf

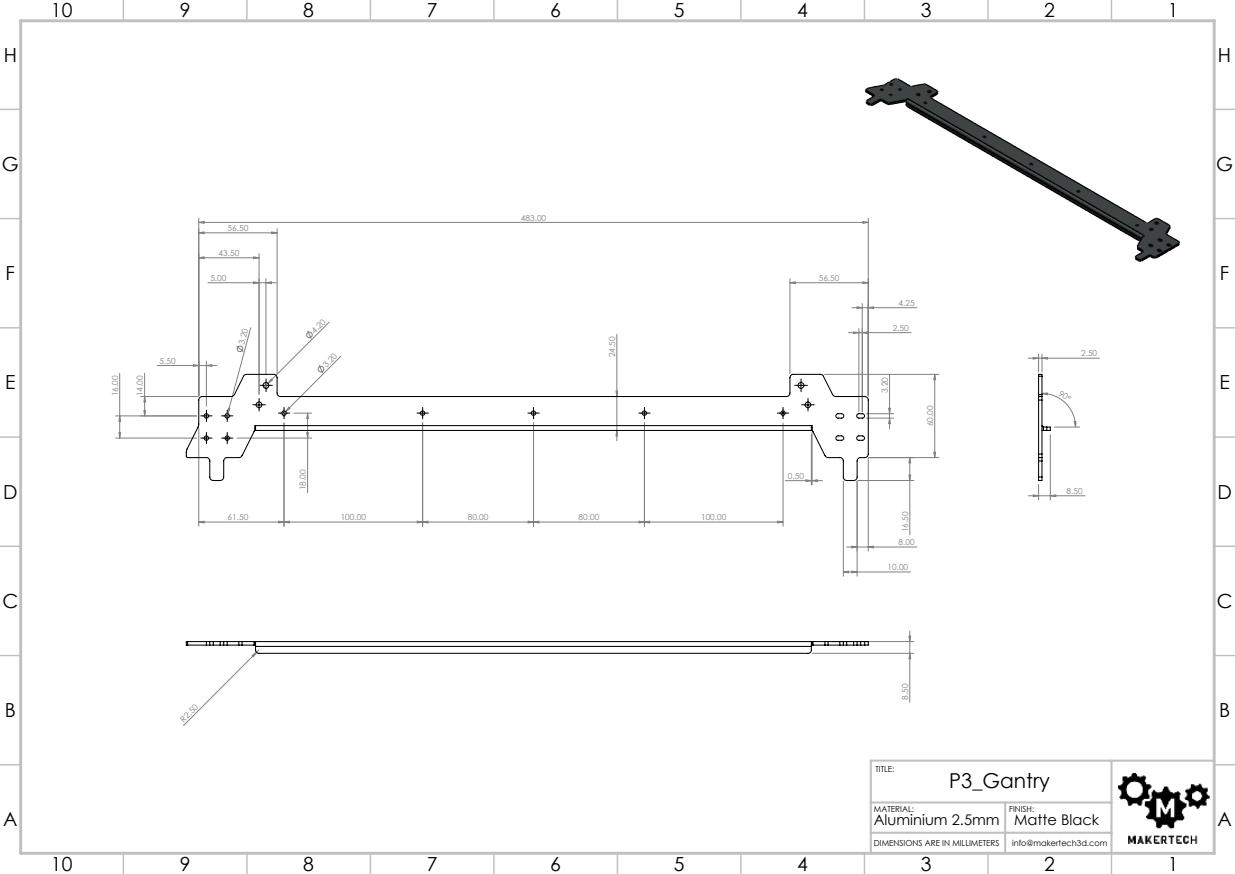
[picture p40: page 1]
Aluminium 2.5mm

TITLE: P3_Gantry

MATERIAL: | FINISH: Matte Black

DIMENSIONS ARE IN MILLIMETERS | info@makertech3d.com
