Makertech3D/Proforge-3/Part Drawings/P3_LCD Case Back_BTT_v3.pdf

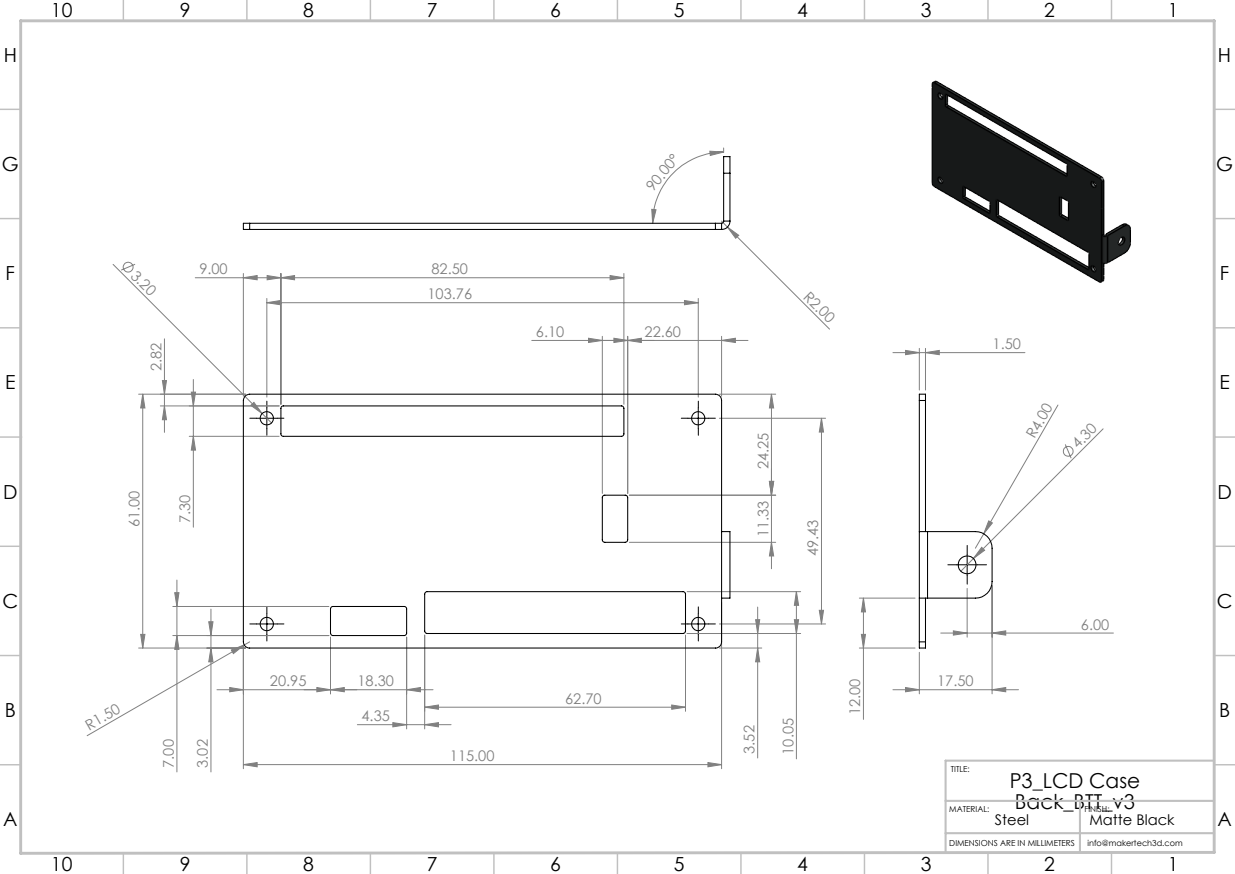
[picture p41: page 1]
P3_LCD Case

MATERIAL: | FINISH: Matte Black

DIMENSIONS ARE IN MILLIMETERS | info@makertech3d.com
