Makertech3D/Proforge-3/Part Drawings/P3_LCD Case_BTT_v3.pdf

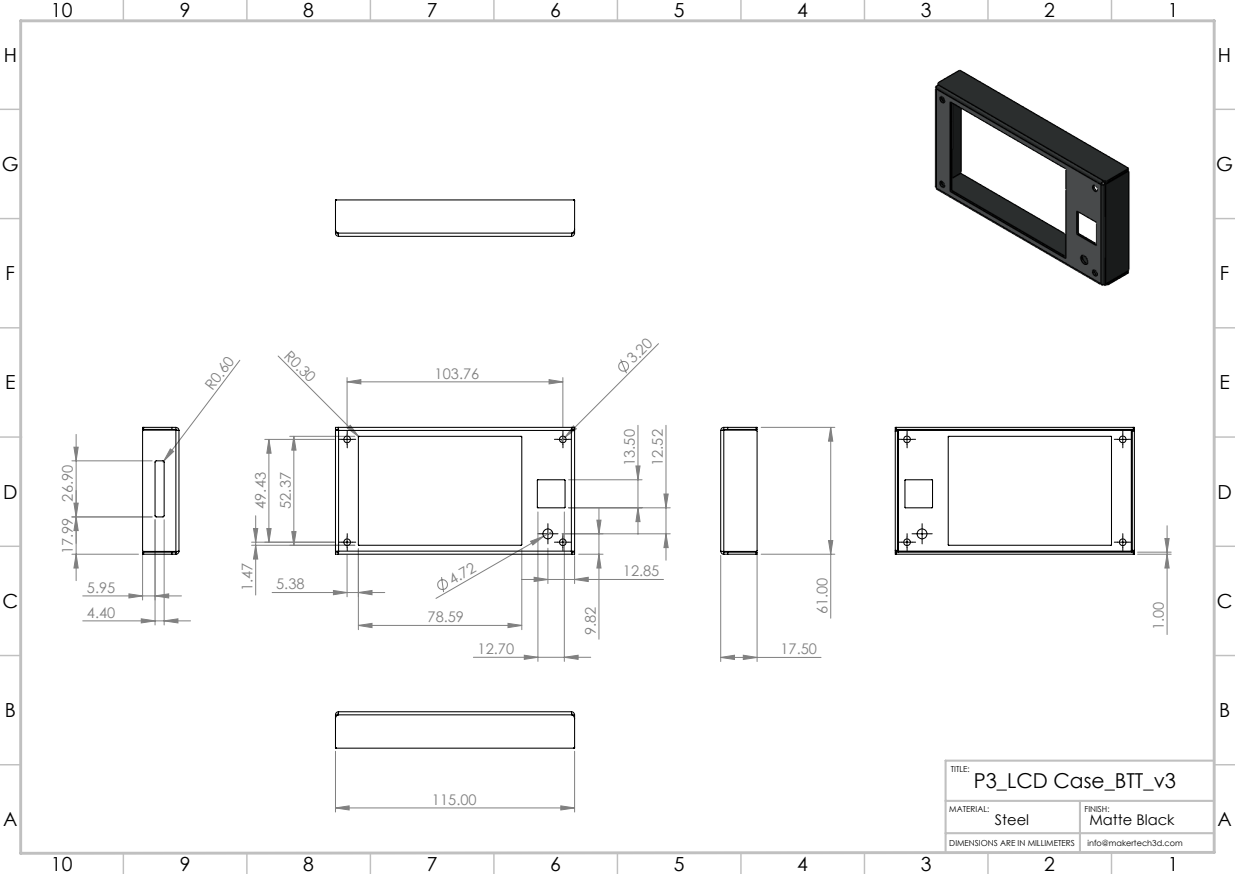
[picture p42: page 1]
P3_LCD Case_BTT_v3

MATERIAL: | FINISH: Matte Black

DIMENSIONS ARE IN MILLIMETERS | info@makertech3d.com
