Makertech3D/Proforge-3/Part Drawings/P3_MIC-6 Platform.pdf

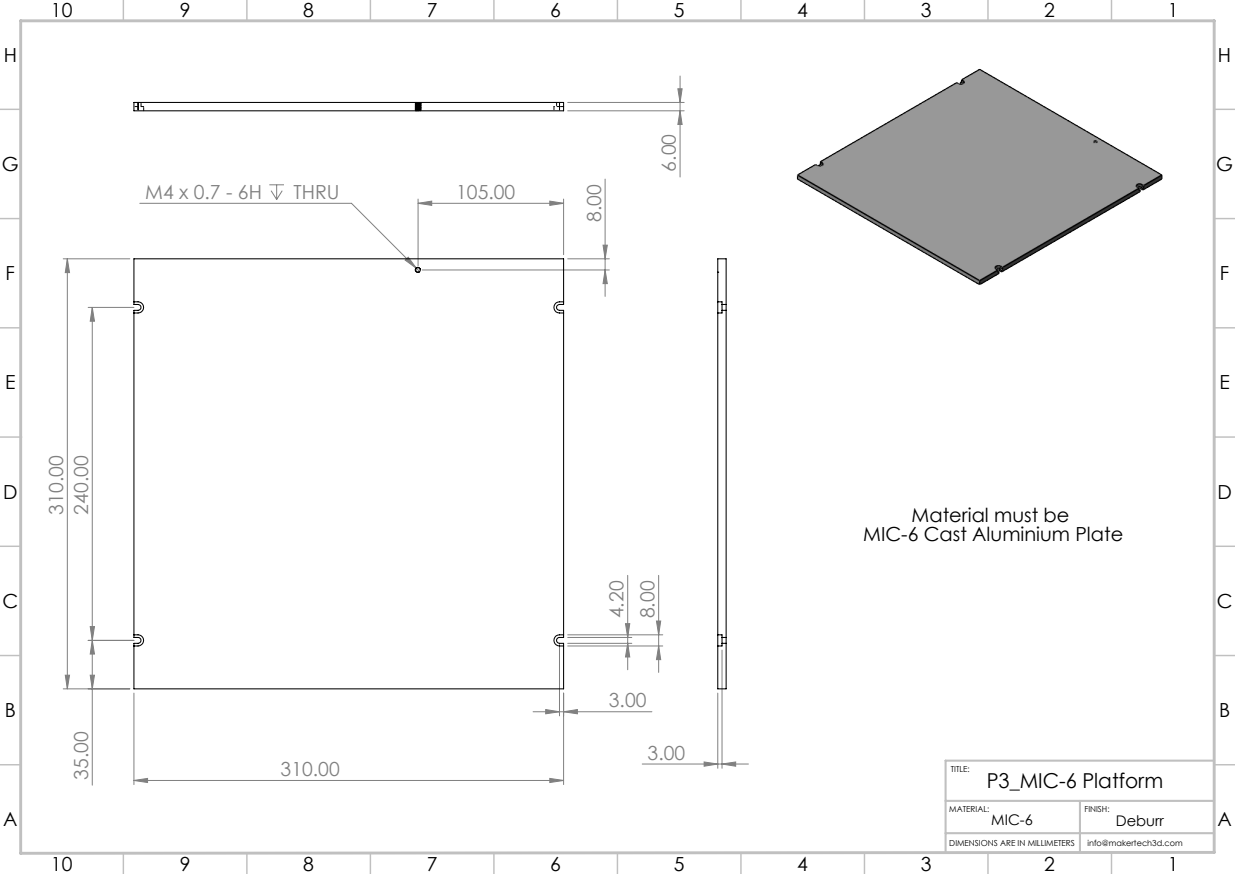
[picture p43: page 1]
M4 x 0.7 - 6H THRU; P3_MIC-6 Platform

Material must be
MIC-6 Cast Aluminium Plate

MATERIAL: | FINISH: Deburr

DIMENSIONS ARE IN MILLIMETERS | info@makertech3d.com
