Makertech3D/Proforge-3/Part Drawings/P3_Pi Cam Case.pdf

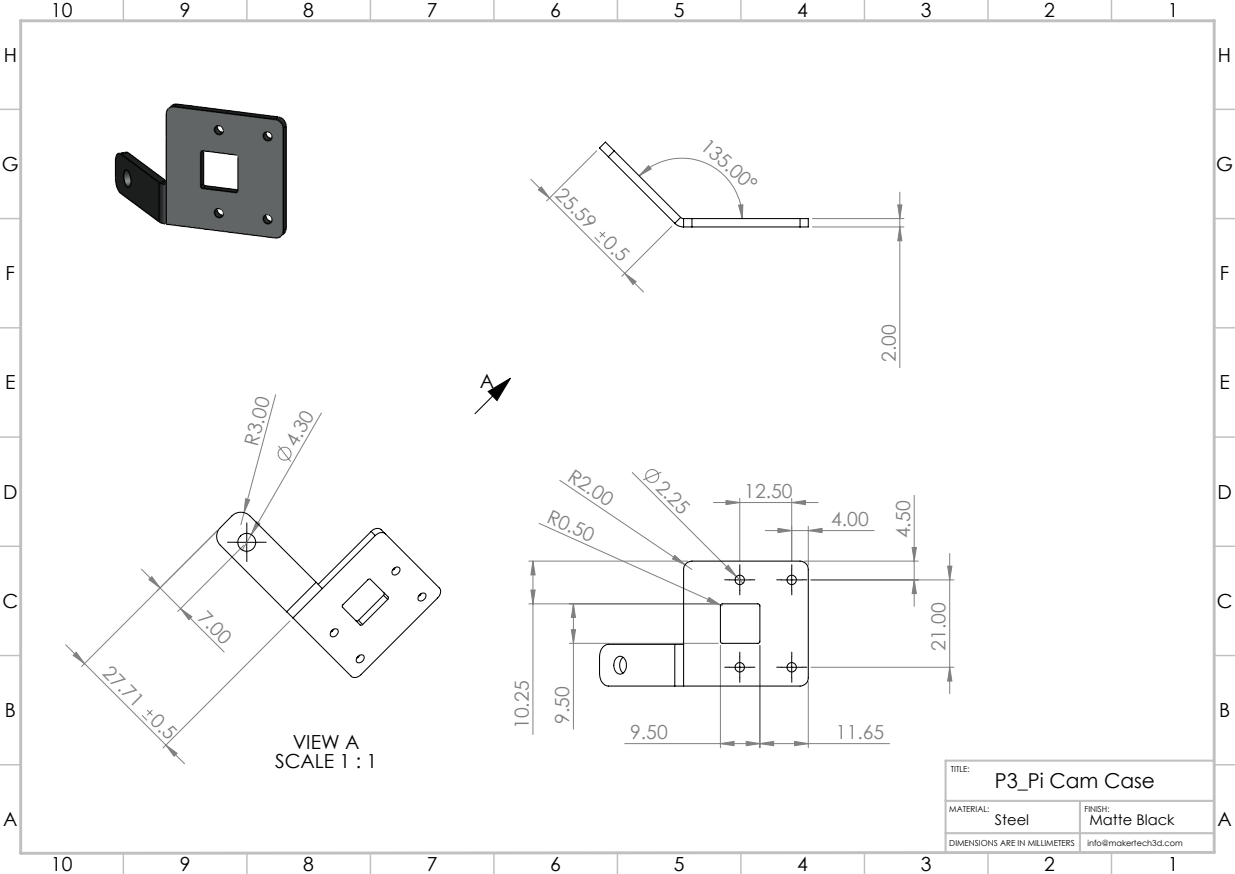
[picture p44: page 1]
VIEW A SCALE 1 : 1; P3_Pi Cam Case

MATERIAL: | FINISH: Matte Black

DIMENSIONS ARE IN MILLIMETERS | info@makertech3d.com
