Makertech3D/Proforge-3/Part Drawings/P3_Platform Panel.pdf

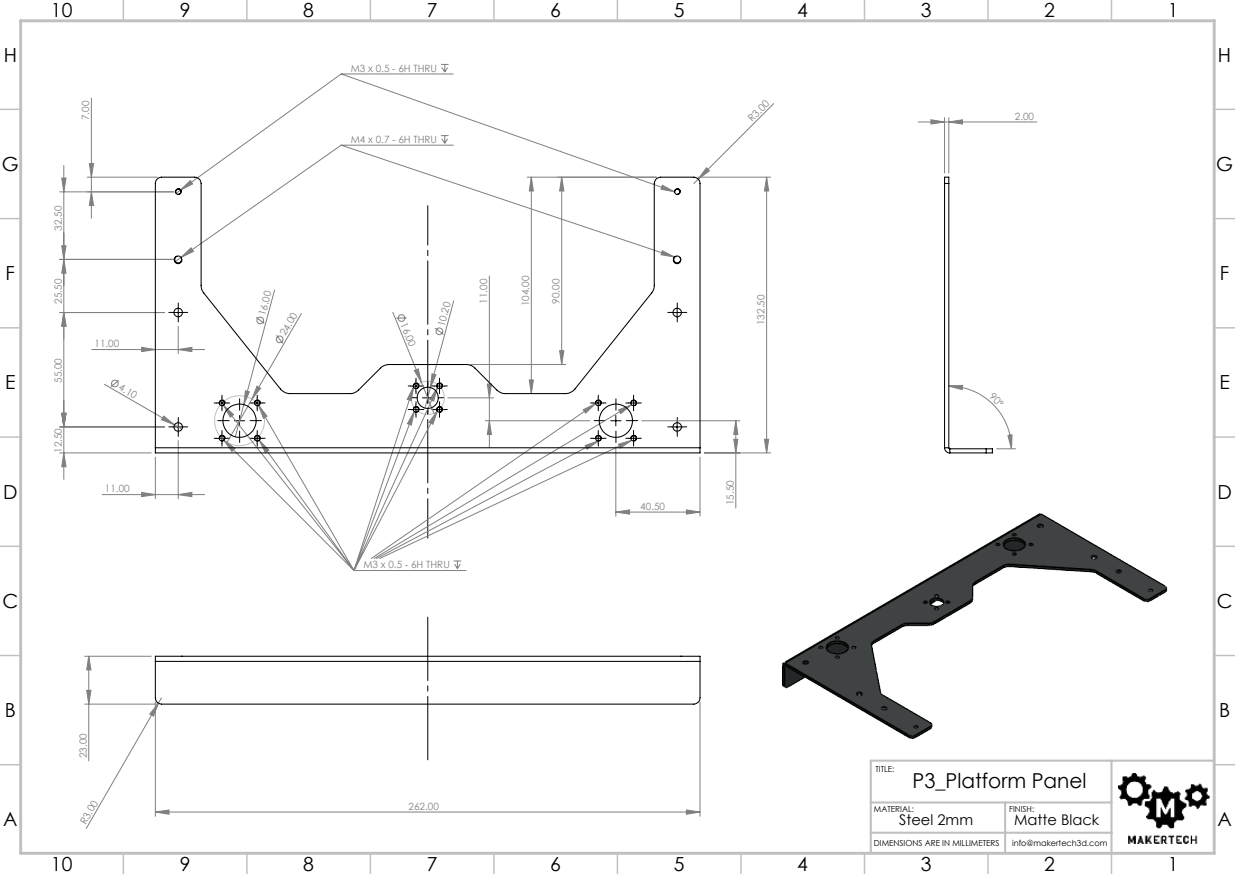
[picture p45: page 1]
M3 x 0.5 - 6H THRU; M4 x 0.7 - 6H THRU; Steel 2mm

TITLE: P3_Platform Panel

MATERIAL: | FINISH: Matte Black

DIMENSIONS ARE IN MILLIMETERS | info@makertech3d.com
