Makertech3D/Proforge-3/Part Drawings/P3_Tool Carriage.pdf

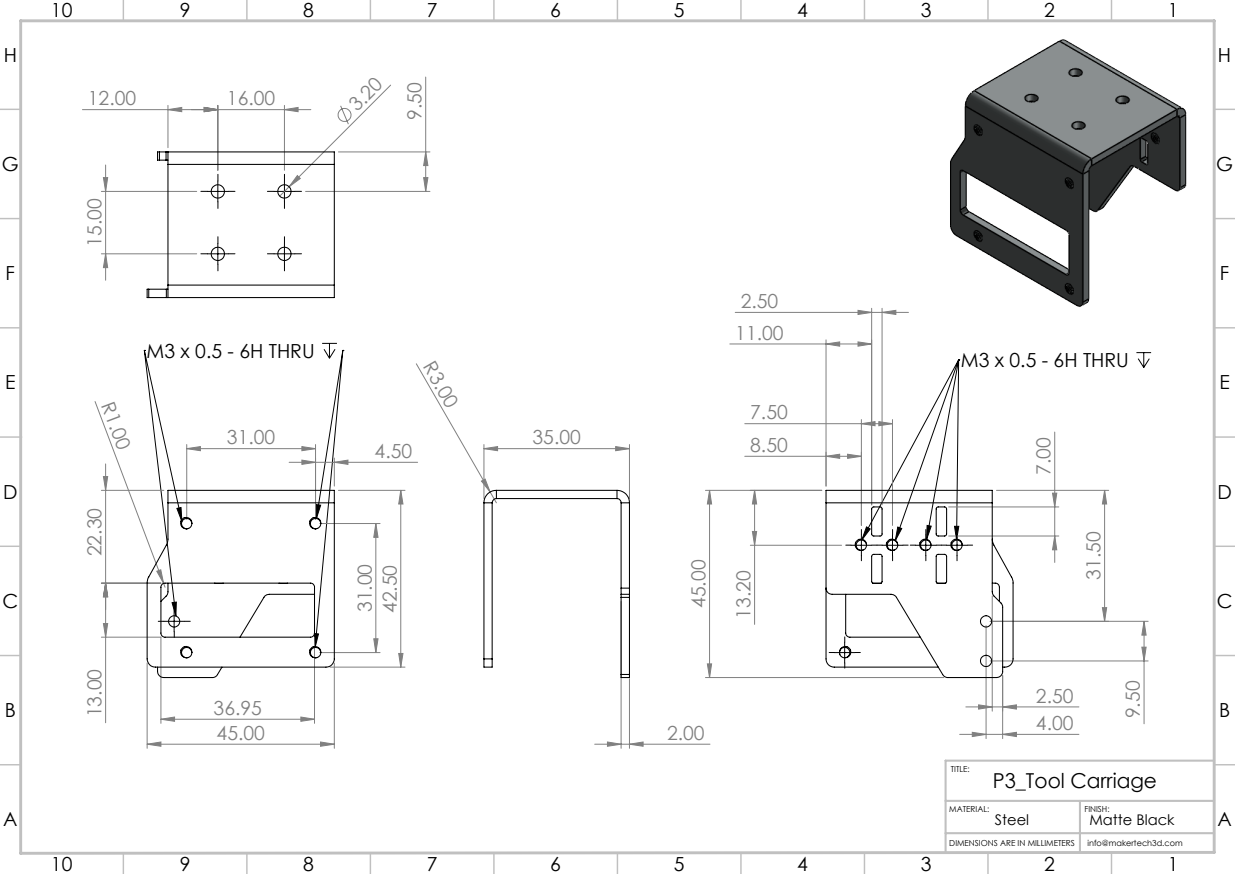
[picture p46: page 1]
M3 x 0.5 - 6H THRU; P3_Tool Carriage

MATERIAL: | FINISH: Matte Black

DIMENSIONS ARE IN MILLIMETERS | info@makertech3d.com
