Makertech3D/Proforge-3/Part Drawings/P3_Top Panel.pdf

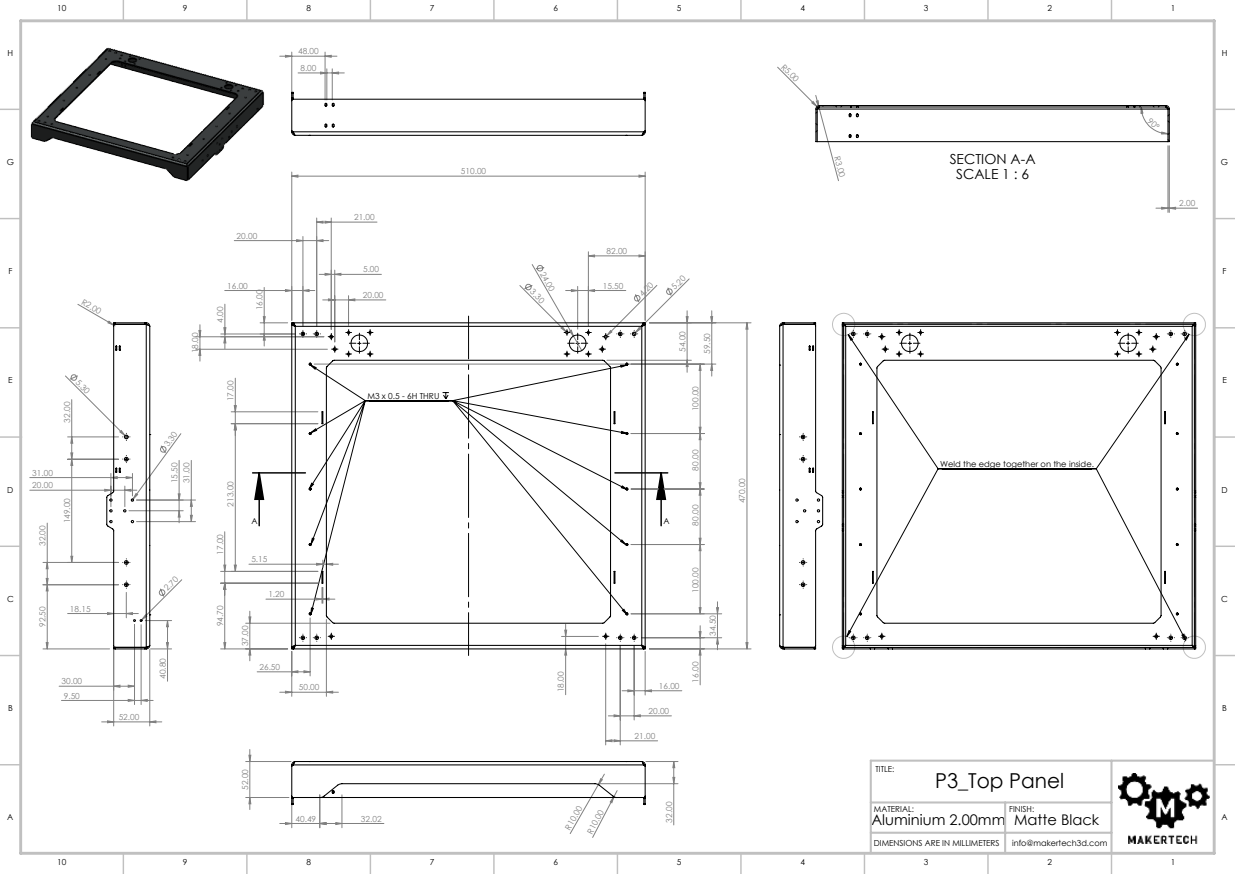
[picture p47: page 1]
M3 x 0.5 - 6H THRU; SECTION A-A SCALE 1 : 6; Aluminium 2.00mm

Weld the edge together on the inside.

TITLE: P3_Top Panel

MATERIAL: | FINISH: Matte Black

DIMENSIONS ARE IN MILLIMETERS | info@makertech3d.com
