Makertech3D/Proforge-3/Part Drawings/Tool Carriage.PDF

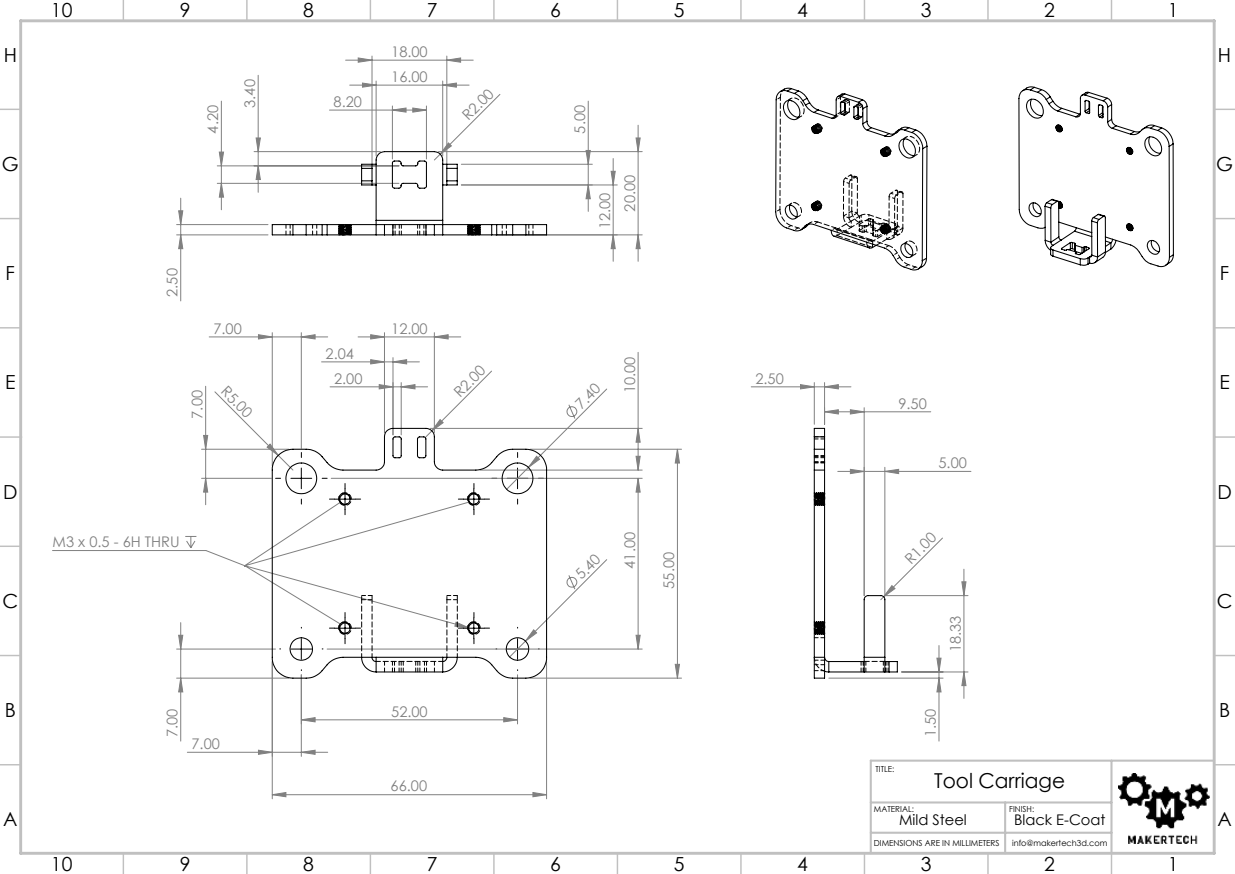
[picture p48: page 1]
M3 x 0.5 - 6H THRU; Mild Steel

TITLE: Tool Carriage

MATERIAL: | FINISH: Black E-Coat

DIMENSIONS ARE IN MILLIMETERS | info@makertech3d.com
