Makertech3D/Proforge-3/(commit log)

2022-03-02 Hotend PID Update
2022-03-02 Upload Marlin Source
2022-03-04 Unified Bed Levelling Update
2022-03-06 Stepper Directions Inverted
2022-03-18 3D printer Part STL's
    [DD 3D Printed Case.STL, DD_Filament Sensor Mount.STL, DSH Fan Mount.STL, DSH Fan Shroud.STL, DSH Probe Mount.STL, Enclosure Filter Case.STL, KIS3R33S Bracket.STL, P3 DD Fan Shroud (mirror for other side).STL]
2022-03-18 3D printed parts STL's
    [DD 3D Printed Case.STL, DD_Filament Sensor Mount.STL, DSH Fan Mount.STL, DSH Fan Shroud.STL, DSH Probe Mount.STL, Enclosure Filter Case.STL, KIS3R33S Bracket.STL, P3 DD Fan Shroud (mirror for other side).STL]
2022-04-09 Firmware Updates
    - Updated Temp. Tables
    - UBL Update
    - X/Y Current Increased
    - X/Y Max Default Max Feedrate 150
2022-04-20 Deactivate servo after move
2022-07-18 Part Drawings
    [DD 3D Printed Case.STL, DD Mount.STEP, DD_Fan Case.STL, DD_Fan Shroud (mirror for other side).STL, DSH Fan Mount.STL, DSH Fan Shroud.STL, DSH Probe Mount.STL, DSH2_Backplate.STEP]
